Guasch5000/RosPiBot/LaTex/template/PFC.tex

%%%%%%%%%%%%%%%%%%%%%%%%%%%%%%%%%%%%%%%%%%%%%%%%%%%%%%%%%%%
%%														%%
%%				Plantilla LaTex PFC ETSEIB				%%
%%														%%
%%					Creado por:							%%
%%						Joan Guasch						%%
%%														%%
%%					Mail:								%%
%%						guasch5000@gmail.com				%%
%%														%%
%%%%%%%%%%%%%%%%%%%%%%%%%%%%%%%%%%%%%%%%%%%%%%%%%%%%%%%%%%%

\documentclass[twoside,12pt,a4paper, openright]{report}

\usepackage{lmodern}
\usepackage[T1]{fontenc}
\usepackage[spanish,activeacute,es-tabla]{babel}
\usepackage{mathtools}
\usepackage{graphicx}
\usepackage[inner=3.0cm,top=2.5cm,outer=2.0cm,bottom=2.5cm]{geometry}  
\usepackage{fancyhdr}
\usepackage{hyperref}
\usepackage{multicol}
\usepackage{float}
\usepackage{eurosym}
\usepackage{datatool}
\usepackage{chngcntr}
\usepackage{pgfgantt}
\usepackage{glossaries}
\usepackage{cite}

\counterwithin{figure}{chapter}
\counterwithin{table}{chapter}

\pagenumbering{gobble}
\usepackage{setspace}
\onehalfspacing

\setlength{\footskip}{42pt}

\title{ }
\author{ }
\date{ } % void to avoid put current date

\pagestyle{fancy}
\fancyhead[LO,RE]{\title{RosPiBot}}
\fancyhead[LE,RO]{\thepage}
\fancyfoot[LE,RO]{}
\fancyfoot[C]{}

\fancypagestyle{plain}{%
\fancyhead[LO,RE]{\title{RosPiBot}}
\fancyhead[LE,RO]{\thepage}
\fancyfoot[LE,RO]{}
\fancyfoot[C]{}
}

\begin{document}

\begin{center}
\vspace{5.0cm} 
 
%\end{center} 
\vspace{2.0cm} 
\LARGE{\\
Proyecto Final de Carrera\\
INGENIER\'IA INDUSTRIAL \\}
\vspace{2.0cm}  %Modificar para adaptar 
\Huge{
T'itulo del proyecto}
\vspace{3.0cm} \\ %Modificar para adaptar 
Memoria
\vspace{2.0cm} \\ %Modificar para adaptar 
\large{$\begin{array}{ll}
\mbox{Autor:} & \mbox{T'u nombre aqu'i} \\
\mbox{Director:} & \mbox{Nombre del director aqu'i} \\
\mbox{Convocatoria:} & \mbox{Mes 20XX}
\end{array}$}\\ 
\vspace{1.5cm} 
\Large{Escuela T'ecnica Superior de Ingenier'ia Industrial de Barcelona}\\ 
\vspace{0.5cm}

\end{center}

\thispagestyle{empty}

\newpage
\thispagestyle{empty}
\paragraph*{}

\newpage

\pagenumbering{arabic}
\fancyhead[LE,RO]{1} 

\addtocontents{toc}{~\hfill\textbf{P'agina}\par}

\begin{abstract}
\thispagestyle{fancy}

\addcontentsline{toc}{section}{Resumen}
En este proyecto... \\

\end{abstract}

\newpage
\fancyhead[LE,RO]{\thepage}
\tableofcontents

\newpage
\fancyhead[LE,RO]{\thepage}
\addcontentsline{toc}{section}{'Indice de figuras}
\listoffigures

\newpage
\fancyhead[LE,RO]{\thepage}
\addcontentsline{toc}{section}{'Indice de tablas}
\listoftables

\newpage
\fancyhead[LE,RO]{\thepage}

\newpage
\chapter*{Acr'onimos}
\addcontentsline{toc}{section}{Acr'onimos}
\begin{description}
\item[UPC] Universitat Politècnica de Catalunya
\end{description}

\newpage
\chapter{Introducci'on}
\section{Motivaci'on}

Este trabajo surge de...\\

\newpage
\section{Objetivos} \label{objetivos}
Los objetivos de...\\

\newpage
\section{Alcance}
El alcance de...\\

\chapter{Cuerpo}
\section{Tema central}

\chapter{Presupuesto}
\section{Planificaci'on}
Este proyecto se ha realizando en ...

\begin{figure}[H]
\begin{center}

\begin{ganttchart}[
vgrid={draw=none, dotted},
hgrid,
link/.style={-latex, red}
]{1}{15}
\gantttitle{Semanas}{15} \\
\gantttitlelist{1,...,15}{1} \\
\ganttbar{Planteamiento}{1}{3} \\

\ganttbar{Nudo}{3}{13}\\
\ganttbar{Desenlace}{14}{15}\\
\ganttlink{elem0}{elem1}
\ganttlink{elem1}{elem2}

\end{ganttchart}

\end{center}
\caption{Diagrama de Gantt}
\label{fig:diagramagantt}
\end{figure}

\chapter{Impacto Ambiental}
\section{Estudio}
El estudio medioambiental muestra que...

\chapter*{Conclusiones}
\addcontentsline{toc}{chapter}{Conclusiones}
A lo largo de este proyecto se han cumplido todos los objetivos propuestos...

\chapter*{Agradecimientos}
\addcontentsline{toc}{chapter}{Agradecimientos}
Un proyecto como este no se podría haber realizado sin...

\begin{thebibliography}{a}
\addcontentsline{toc}{chapter}{Bibliograf'aa}

\bibitem{ros} \textsc{Mart'inez, A. y Fern'andez, E.},
\textit{Learning ROS for Robotics Programming.}
PACKT Publishing, 2013  

\end{thebibliography}

\chapter*{Soporte infrom'atico}
\addcontentsline{toc}{chapter}{Soporte inform'atico}

\textbf{\LaTeX } Linux, Mac y Windows\\
Sistema de composición de textos, orientado especialmente a la creación de libros, documentos científicos y técnicos que contengan fórmulas matemáticas.\\

\end{document}
