Guasch5000/RosPiBot/Kicad/SecurePi_Board/nanain drill.PNG

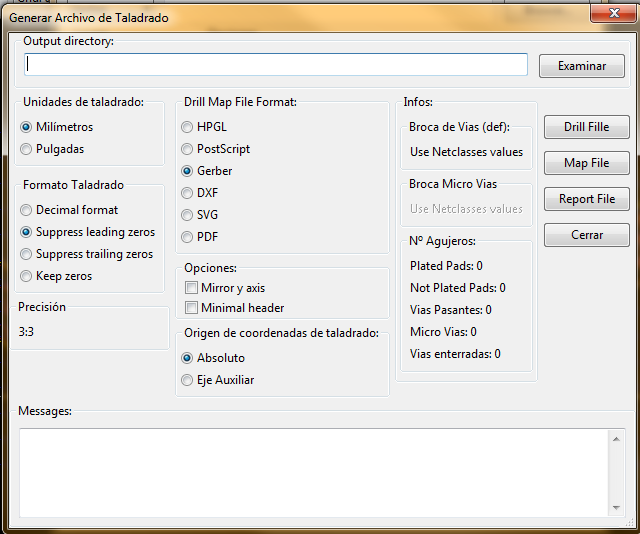
Kicad/SecurePi_Board/nanain drill.PNG
