Guasch5000/RosPiBot/Kicad/SecurePi_Board/nanain.PNG

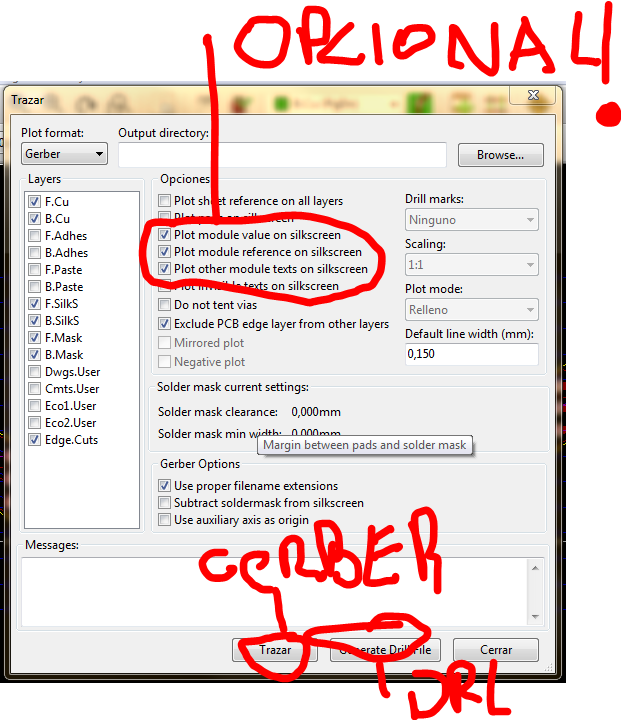
Kicad/SecurePi_Board/nanain.PNG
