Guasch5000/RosPiBot/Kicad/SecurePi_Board/securePscreen shoti.png

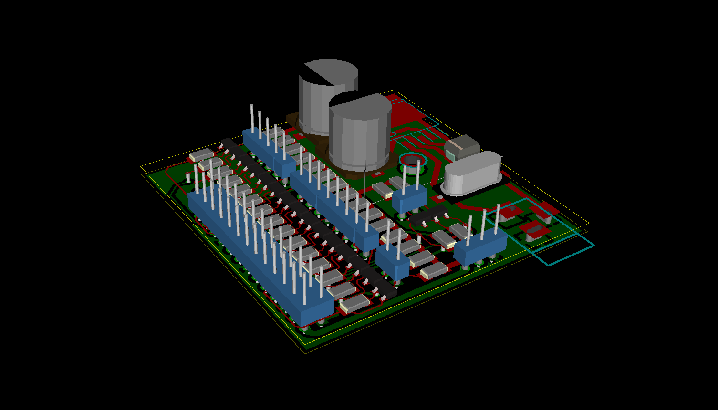
Kicad/SecurePi_Board/securePscreen shoti.png
