Guasch5000/RosPiBot/Kicad/SecurePi_Board/securePscreenshot2.png

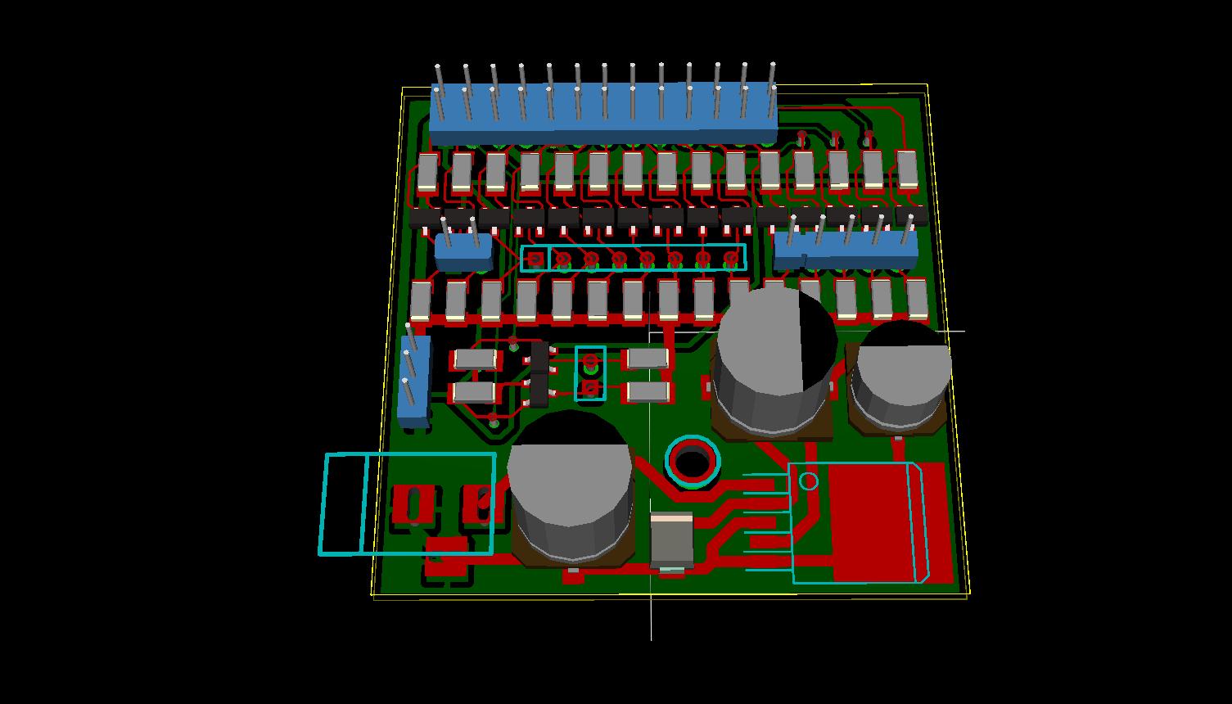
Kicad/SecurePi_Board/securePscreenshot2.png
