Guasch5000/RosPiBot/Kicad/SecurePi_Board/securePscreenshot3.png

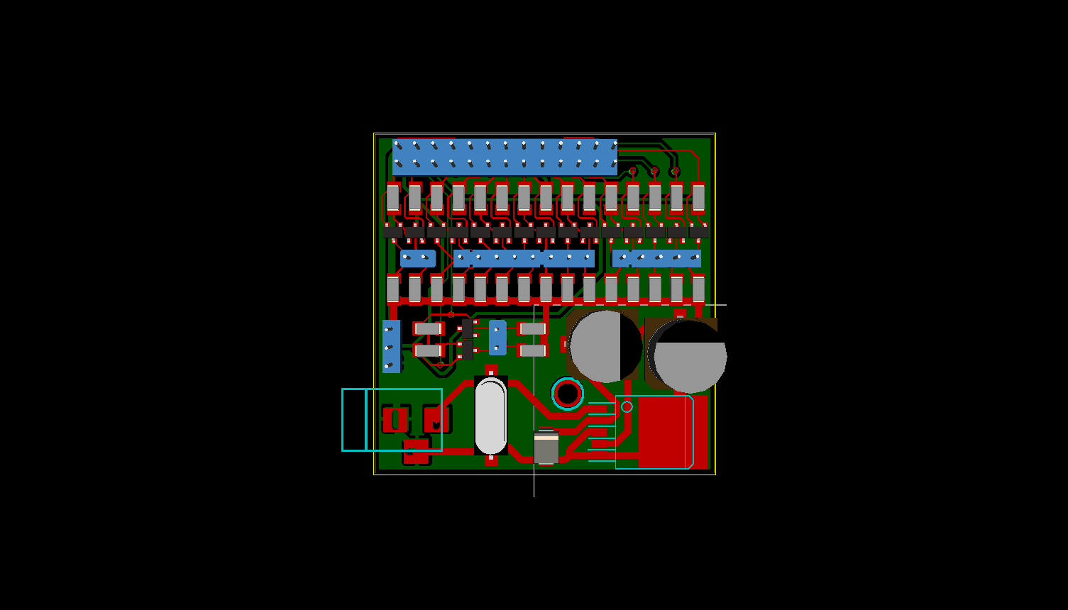
Kicad/SecurePi_Board/securePscreenshot3.png
