Guasch5000/RosPiBot/Kicad/SensorPi _Board/SensorPi_screenshoot1.png

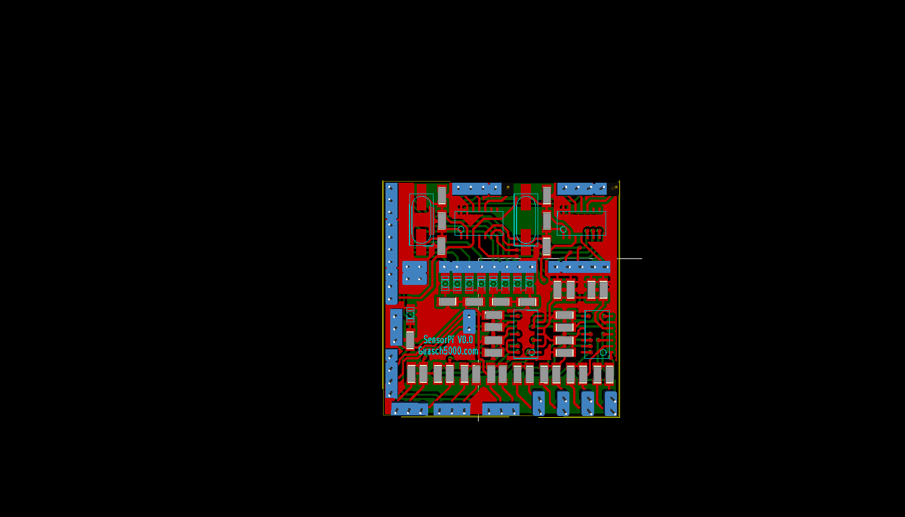
Kicad/SensorPi _Board/SensorPi_screenshoot1.png
