Guasch5000/RosPiBot/Kicad/SensorPi _Board/SensorPi_screenshoot2.png

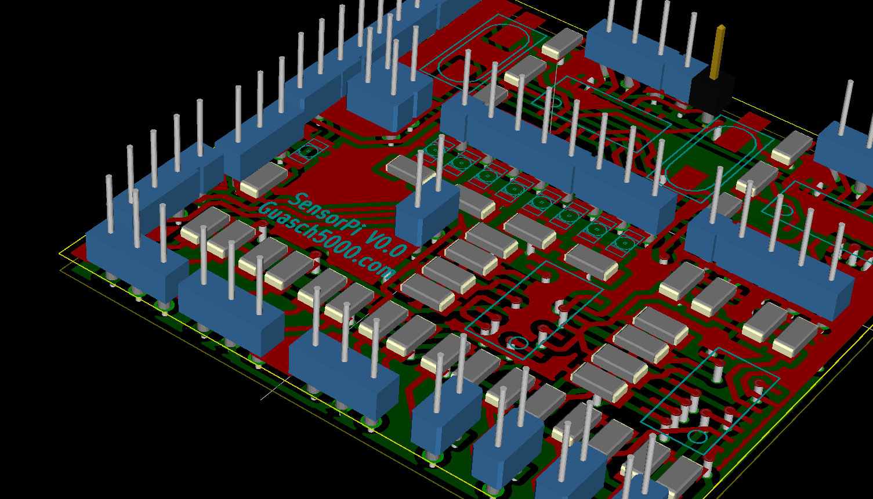
Kicad/SensorPi _Board/SensorPi_screenshoot2.png
