Guasch5000/RosPiBot/Kicad/SensorPi _Board/SensorPi_screenshoot3.png

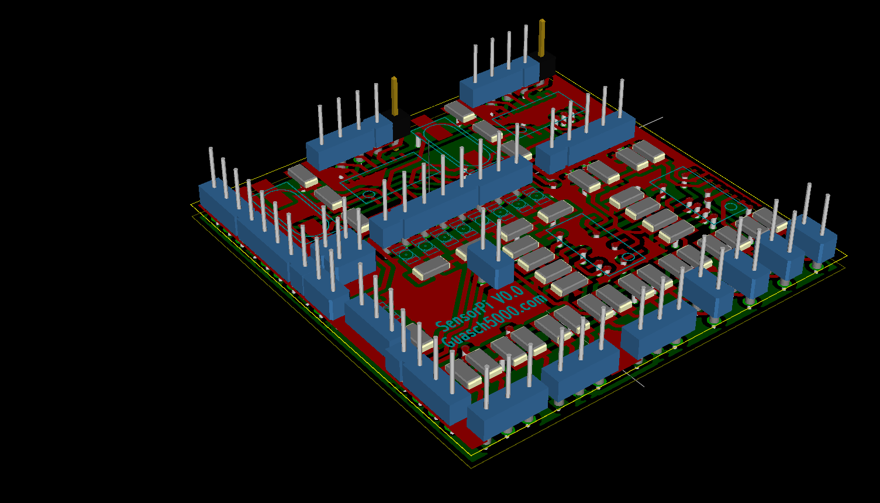
Kicad/SensorPi _Board/SensorPi_screenshoot3.png
