Guasch5000/RosPiBot/SolidWorks/Rueda Derecha.SLDASM

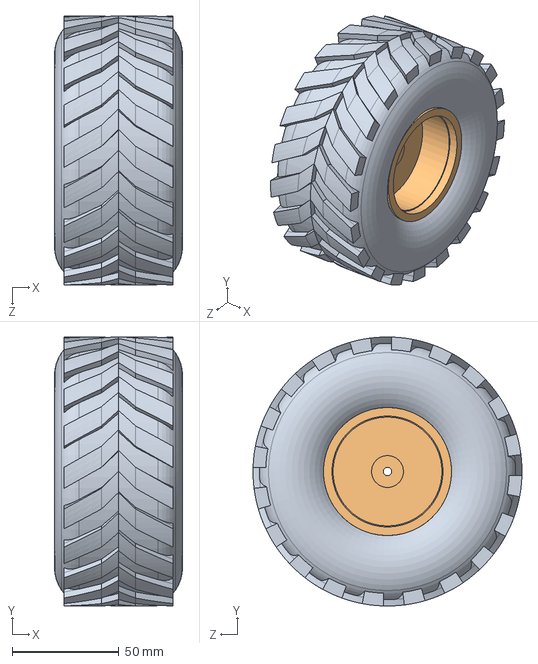
[picture p70: CAD file, 2014-05-18]
SolidWorks/Rueda Derecha.SLDASM
60.0 x 126.0 x 126.0 mm
Pneumatico
Llanta
