Guasch5000/RosPiBot/SolidWorks/Ensamblaje escuadra.SLDASM

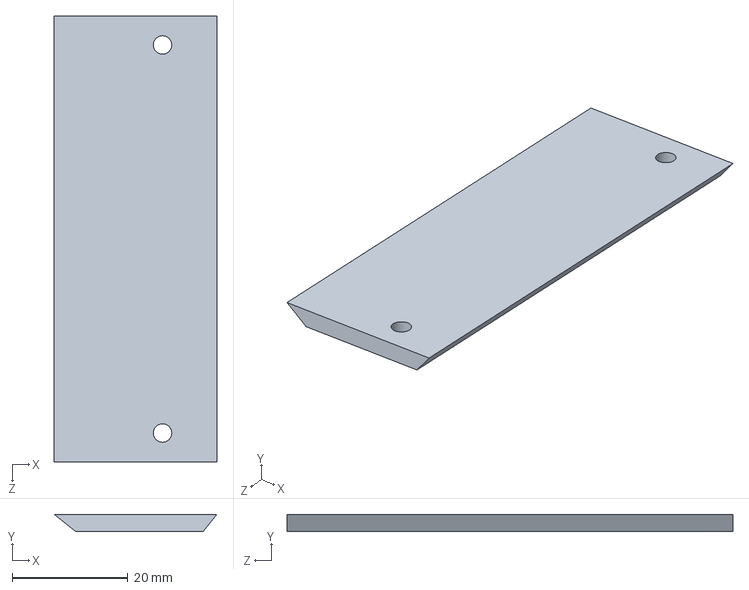
[picture p71: CAD file, 2014-05-18]
SolidWorks/Ensamblaje escuadra.SLDASM
28.1 x 3.00 x 77.0 mm
