Guasch5000/RosPiBot/SolidWorks/RosPiBot.SLDASM

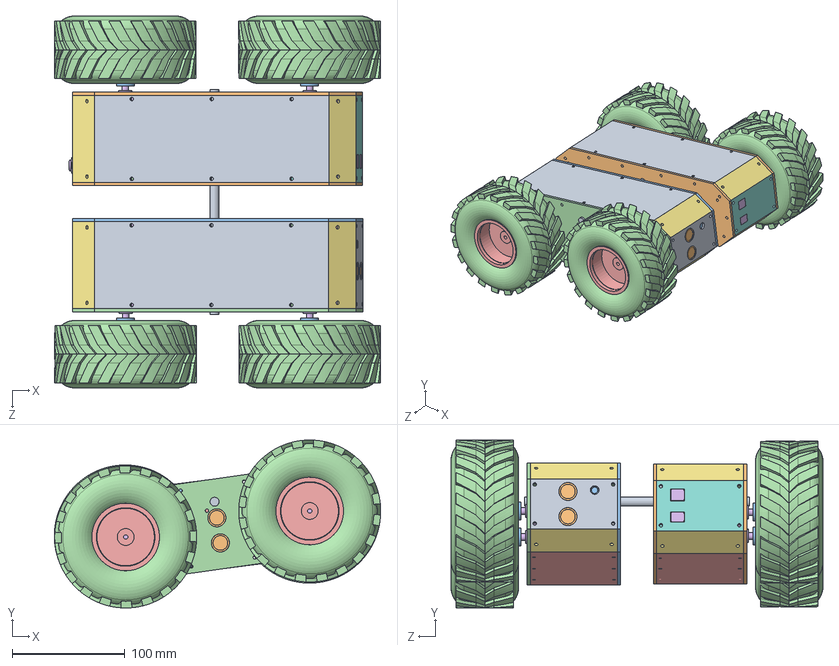
[picture p72: CAD file, 2014-05-18]
SolidWorks/RosPiBot.SLDASM
289.7 x 149.1 x 330.2 mm
Barra transversal
tapa lateral interior izquierda
tapa lateral interior derecha
Perfiles Estructura x 8
tapa inferior x 2
soporte interior ethernet
soporte interior switch
soporte interior raspberry
Switch
Ethernet panel mount
RaspberryPi
SecurePi
SensorPi
soporte router izquierdo
soporte drivers derecho
soporte bateria derecho
soporte bateria izquierdo
soporte driver izquierdo
MotorPi
Bateria 7.4V 6000mAh
soporte escuadras derechas x 8
soporte escuadras izquierdas x 8
tapa escuadra x 8
soporte delantero derecho
Panel delantero derecho
Sonar KS103 x 4
RaspiCam
soporte trasero derecho uno
soporte trasero derecho dos
Sharp 2Y0A02 x 2
USB panel mount x 2
panel trasero derecho
tapa superior x 2
soporte router derecho
Router
tapa lateral exterior derecha
prisma x 2
Motor Hsiang Neng x 4
soporte delantero izquierdo
Panel delantero izquierdo
soporte simple x 2
panel trasero izquierdo
soporte trasero izquierdo
Led 10 Bar
Jack Power
Int antivandalico
Porta fusible
GY-80
soporte imu
tapa lateral exterior izquierda
Coupling x 4
Pneumatico x 4
Llanta x 4
