Guasch5000/RosPiBot/SolidWorks/SensorPi.SLDPRT

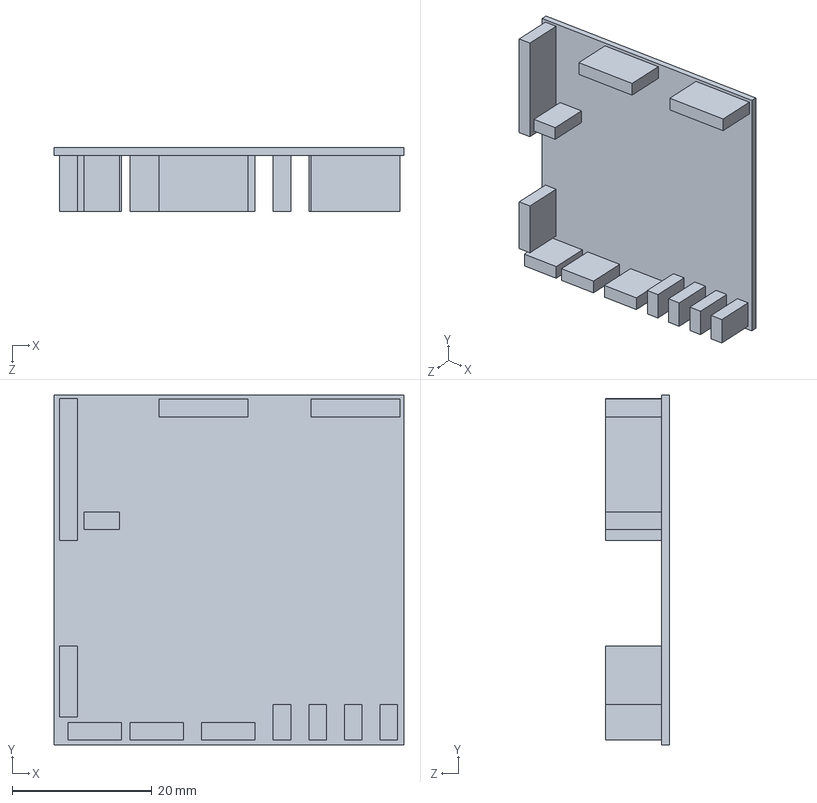
[picture p73: CAD file, 2014-05-18]
SolidWorks/SensorPi.SLDPRT
50.0 x 50.0 x 9.20 mm
