Guasch5000/RosPiBot/SolidWorks/tapa superior.SLDPRT

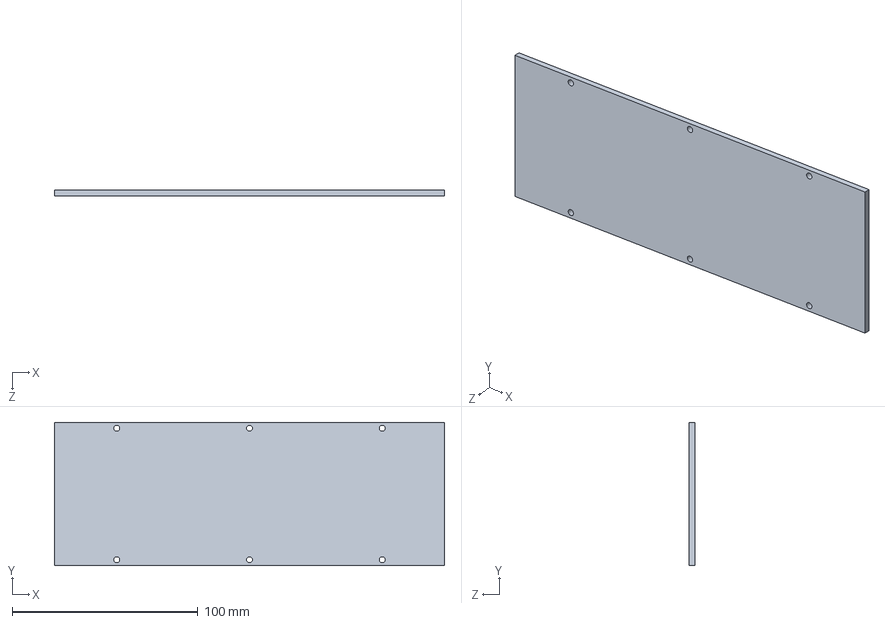
[picture p74: CAD file, 2014-05-18]
SolidWorks/tapa superior.SLDPRT
210.0 x 77.0 x 3.00 mm
