Guasch5000/RosPiBot/SolidWorks/soporte delantero izquierdo.SLDPRT

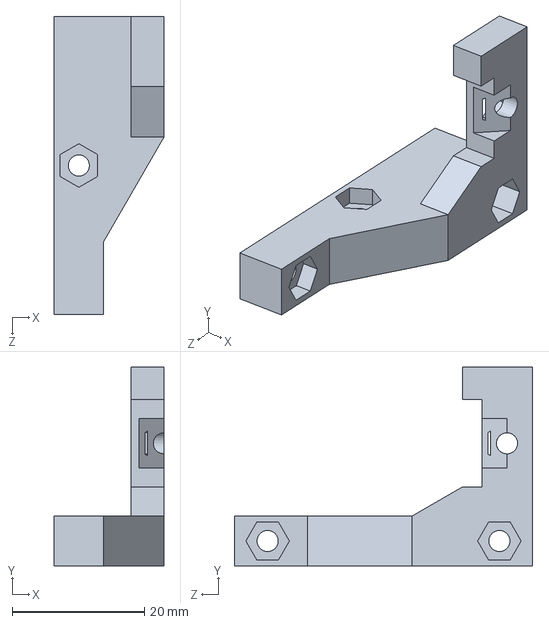
[picture p75: CAD file, 2014-05-18]
SolidWorks/soporte delantero izquierdo.SLDPRT
16.6 x 30.0 x 45.0 mm
