Guasch5000/RosPiBot/SolidWorks/tapa lateral exterior derecha.SLDPRT

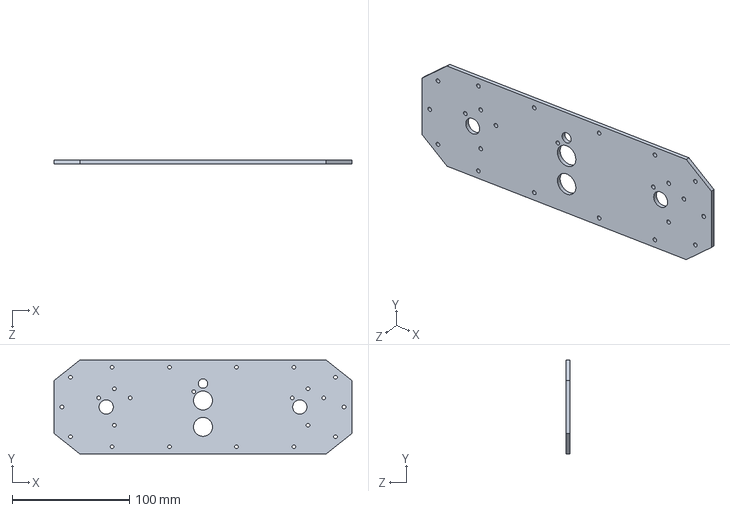
[picture p76: CAD file, 2014-05-18]
SolidWorks/tapa lateral exterior derecha.SLDPRT
254.0 x 80.0 x 3.00 mm
