Guasch5000/RosPiBot/SolidWorks/soporte imu.SLDPRT

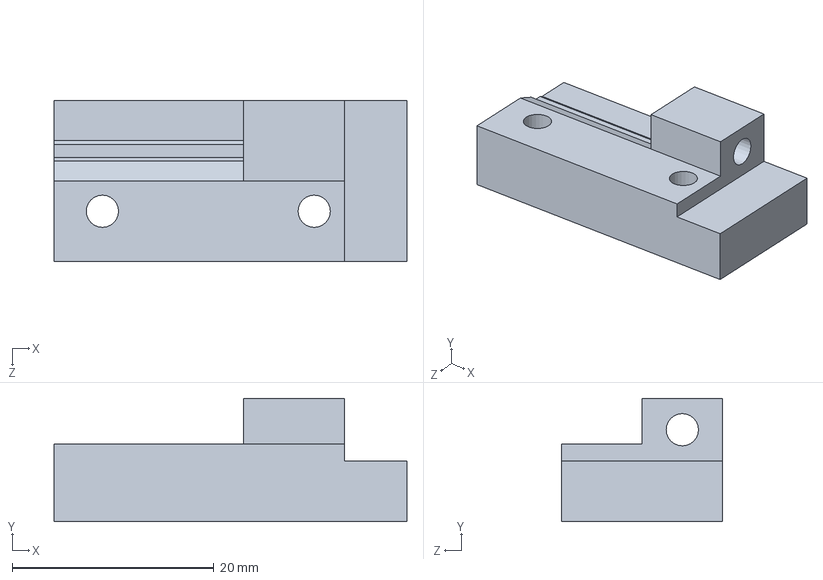
[picture p77: CAD file, 2014-05-18]
SolidWorks/soporte imu.SLDPRT
35.0 x 12.2 x 16.0 mm
