Guasch5000/RosPiBot/SolidWorks/Llanta.SLDPRT

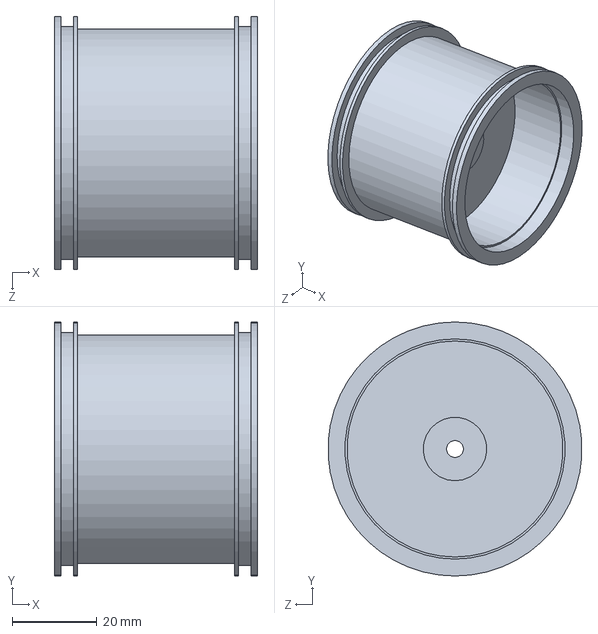
[picture p78: CAD file, 2014-05-18]
SolidWorks/Llanta.SLDPRT
48.0 x 60.0 x 59.9 mm
