Guasch5000/RosPiBot/SolidWorks/soporte trasero derecho dos.SLDPRT

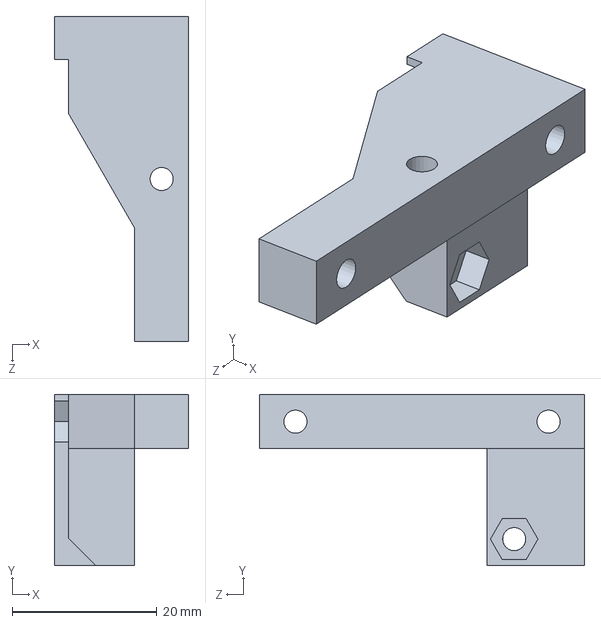
[picture p79: CAD file, 2014-05-18]
SolidWorks/soporte trasero derecho dos.SLDPRT
18.6 x 23.6 x 45.0 mm
