Guasch5000/RosPiBot/SolidWorks/Panel delantero izquierdo.SLDPRT

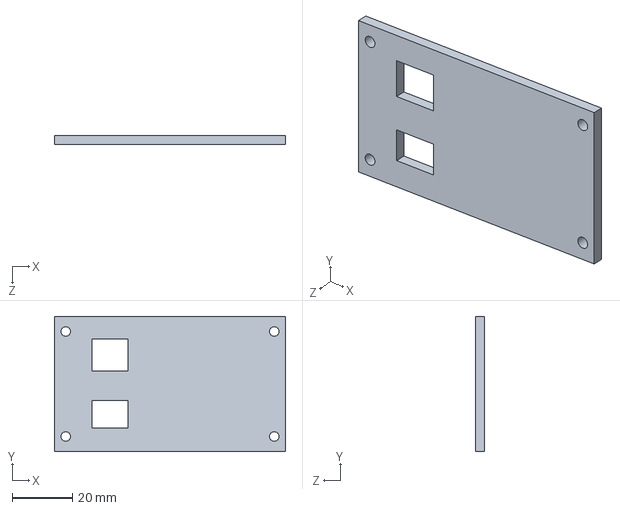
[picture p80: CAD file, 2014-05-18]
SolidWorks/Panel delantero izquierdo.SLDPRT
77.0 x 45.0 x 3.00 mm
