Guasch5000/RosPiBot/SolidWorks/Jack Power.SLDPRT

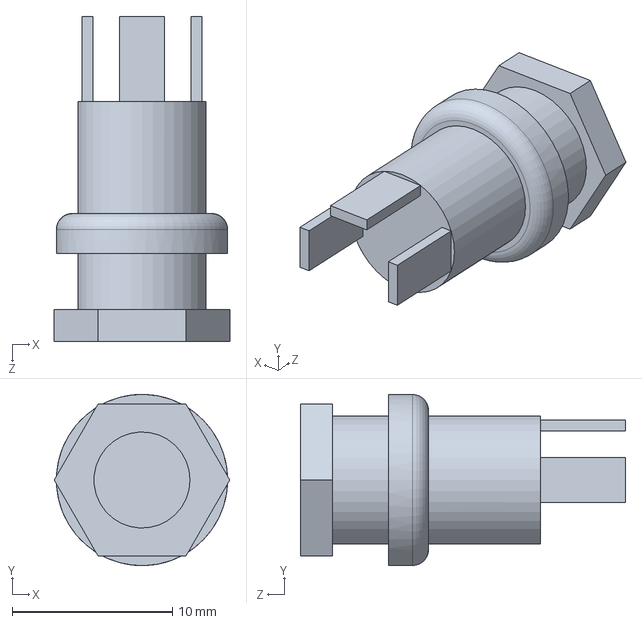
[picture p81: CAD file, 2014-05-18]
SolidWorks/Jack Power.SLDPRT
11.0 x 10.7 x 20.3 mm
