Guasch5000/RosPiBot/SolidWorks/soporte simple.SLDPRT

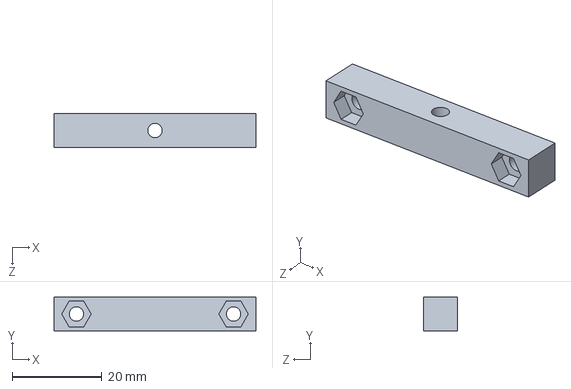
[picture p82: CAD file, 2014-05-18]
SolidWorks/soporte simple.SLDPRT
45.0 x 7.50 x 7.50 mm
