Guasch5000/RosPiBot/SolidWorks/soporte delantero derecho.SLDPRT

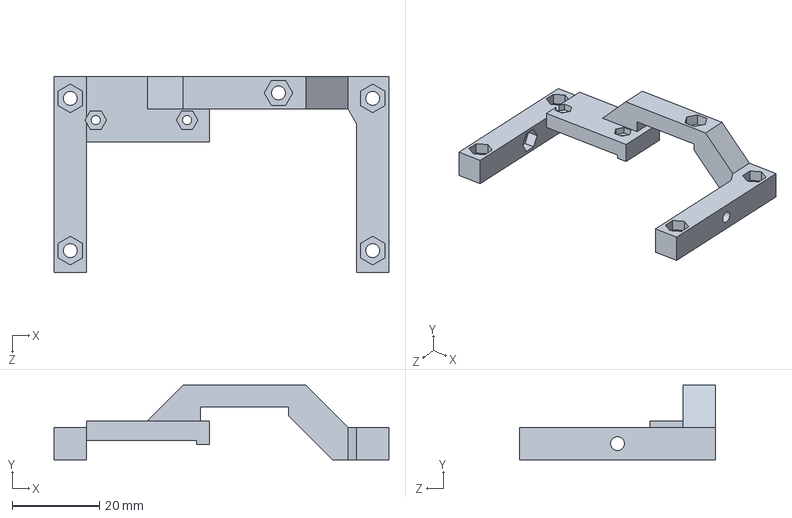
[picture p83: CAD file, 2014-05-18]
SolidWorks/soporte delantero derecho.SLDPRT
77.0 x 17.2 x 45.0 mm
