Guasch5000/RosPiBot/SolidWorks/panel trasero derecho.SLDPRT

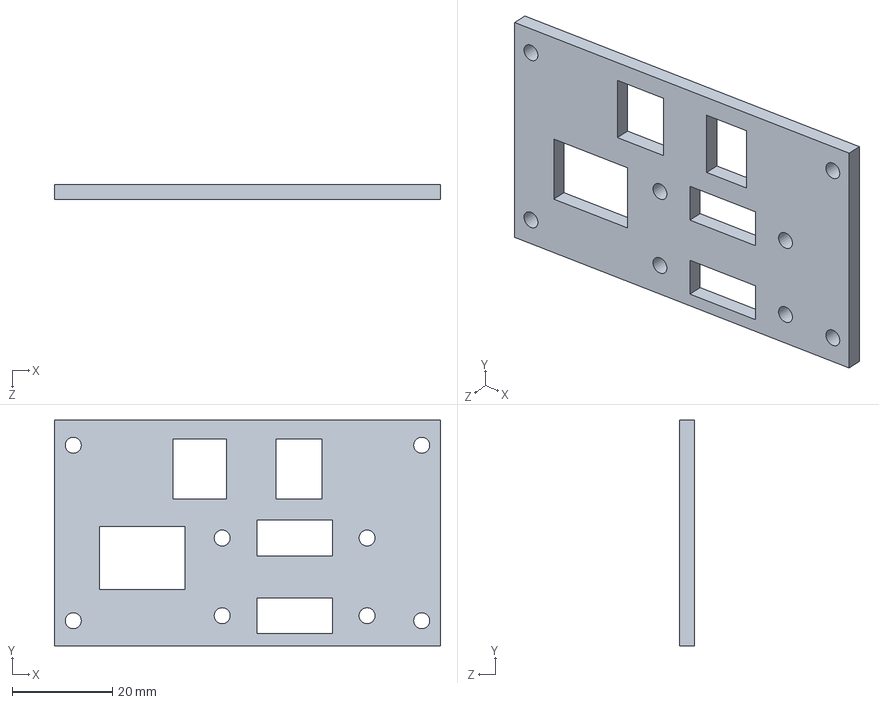
[picture p84: CAD file, 2014-05-18]
SolidWorks/panel trasero derecho.SLDPRT
77.0 x 45.0 x 3.00 mm
