Guasch5000/RosPiBot/SolidWorks/soporte interior raspberry.SLDPRT

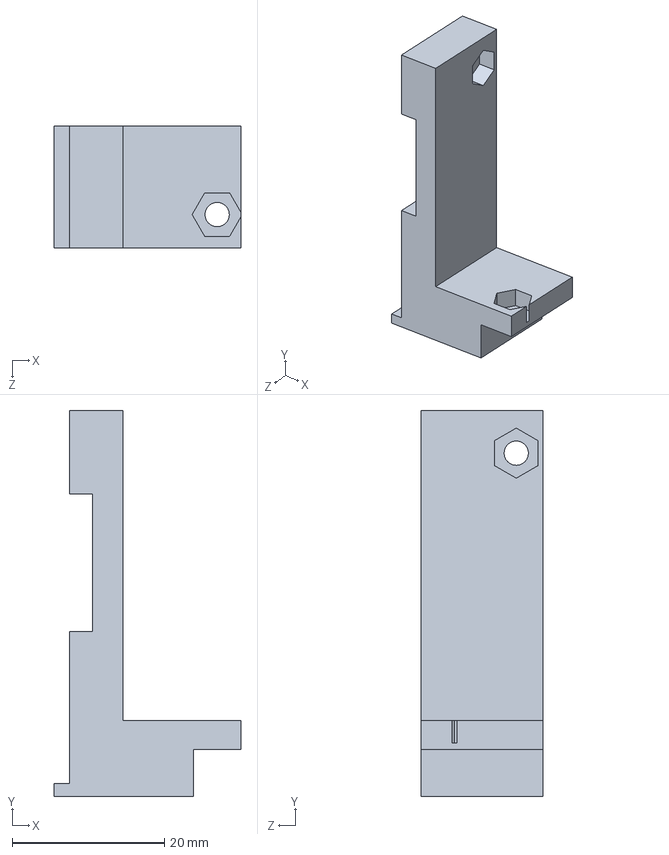
[picture p85: CAD file, 2014-05-18]
SolidWorks/soporte interior raspberry.SLDPRT
24.5 x 50.7 x 16.0 mm
