Guasch5000/RosPiBot/SolidWorks/soporte bateria izquierdo.SLDPRT

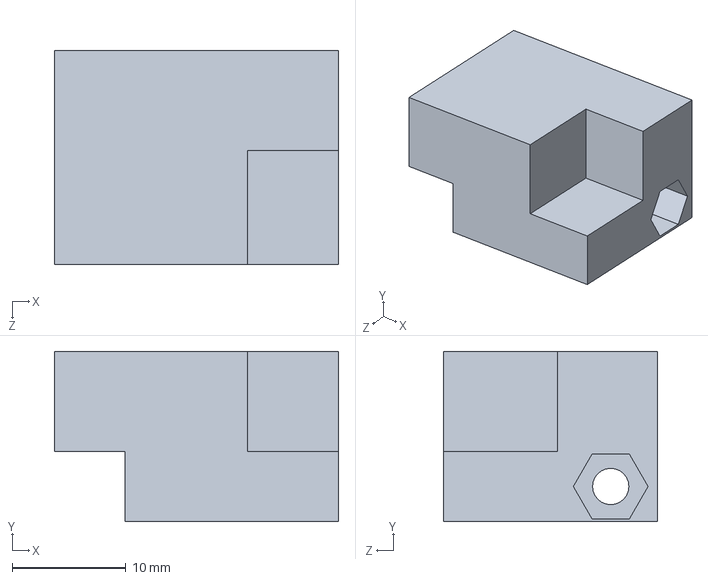
[picture p86: CAD file, 2014-05-18]
SolidWorks/soporte bateria izquierdo.SLDPRT
25.0 x 15.0 x 18.8 mm
