Guasch5000/RosPiBot/SolidWorks/Lateral derecho externo placa test.SLDPRT

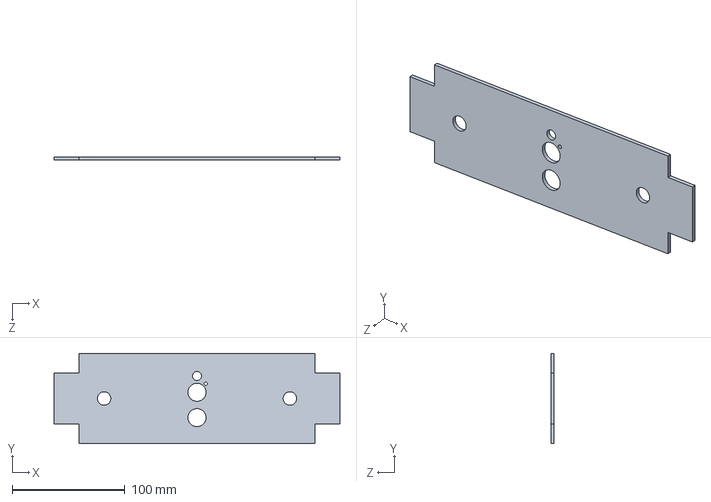
[picture p87: CAD file, 2014-05-18]
SolidWorks/Lateral derecho externo placa test.SLDPRT
254.0 x 80.0 x 3.00 mm
