Guasch5000/RosPiBot/SolidWorks/tapa escuadra.SLDPRT

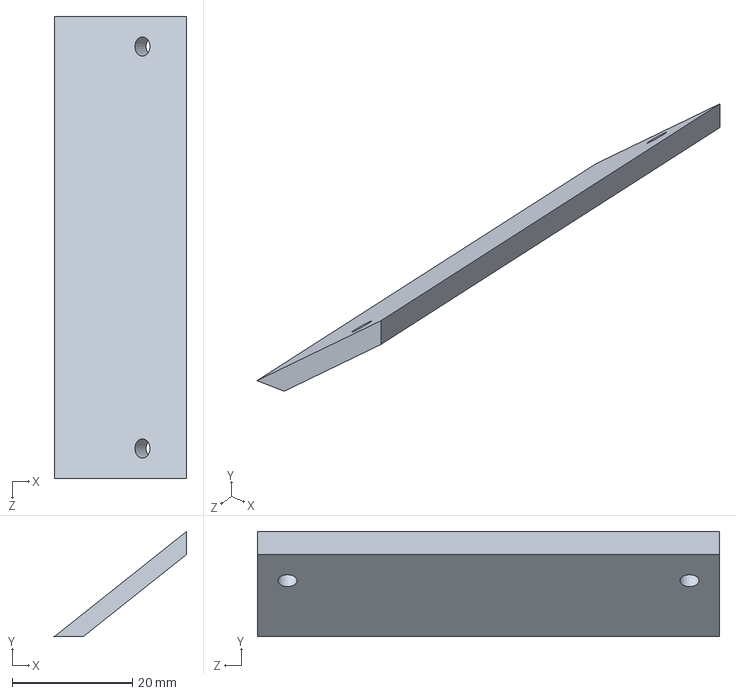
[picture p88: CAD file, 2014-05-18]
SolidWorks/tapa escuadra.SLDPRT
22.0 x 17.5 x 77.0 mm
