Guasch5000/RosPiBot/SolidWorks/Placa test.SLDPRT

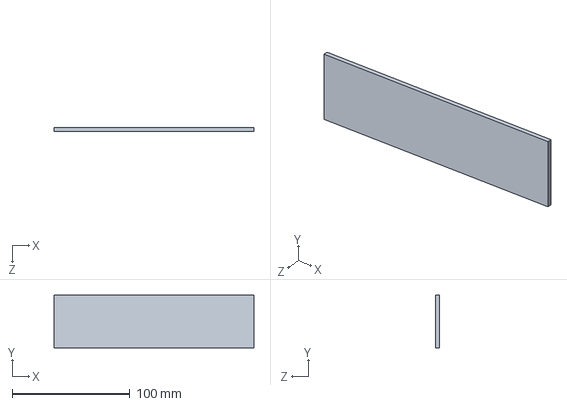
[picture p89: CAD file, 2014-05-18]
SolidWorks/Placa test.SLDPRT
170.0 x 45.0 x 3.00 mm
