Guasch5000/RosPiBot/SolidWorks/soporte router derecho.SLDPRT

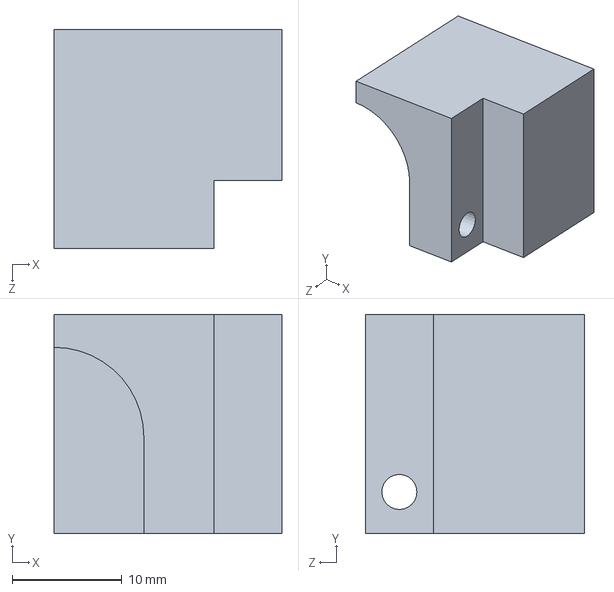
[picture p90: CAD file, 2014-05-18]
SolidWorks/soporte router derecho.SLDPRT
20.8 x 20.0 x 20.0 mm
