Guasch5000/RosPiBot/SolidWorks/USB panel mount.SLDPRT

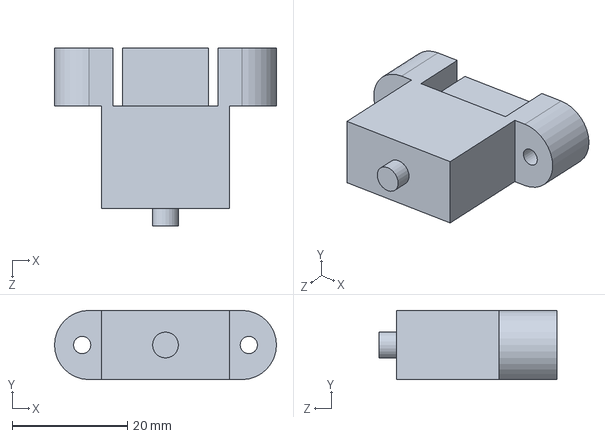
[picture p91: CAD file, 2014-05-18]
SolidWorks/USB panel mount.SLDPRT
38.5 x 12.0 x 30.8 mm
