Guasch5000/RosPiBot/SolidWorks/GY-80.SLDPRT

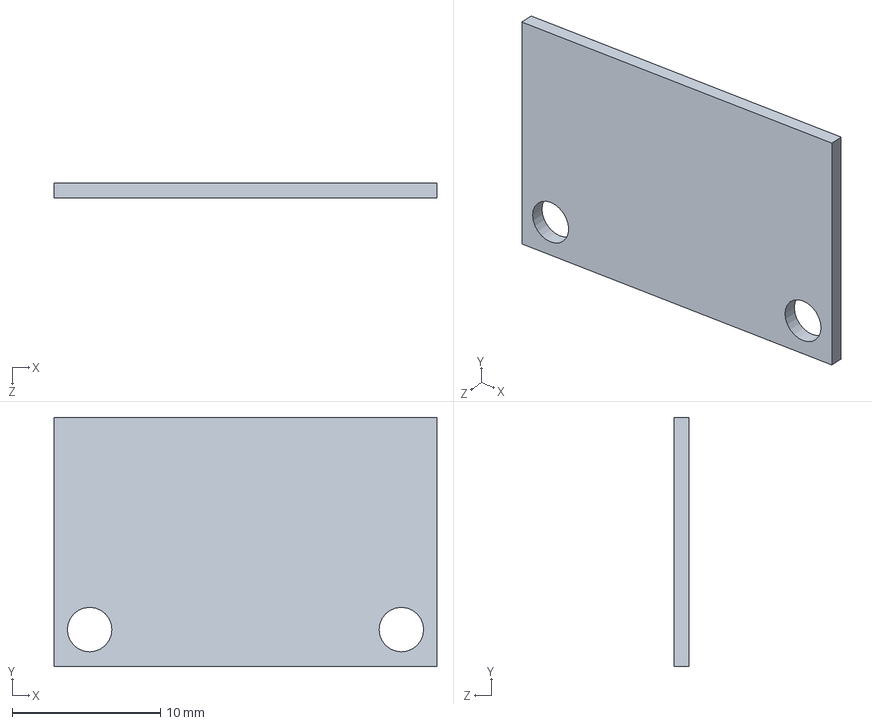
[picture p92: CAD file, 2014-05-18]
SolidWorks/GY-80.SLDPRT
25.8 x 16.8 x 1.00 mm
