Guasch5000/RosPiBot/SolidWorks/soporte driver izquierdo.SLDPRT

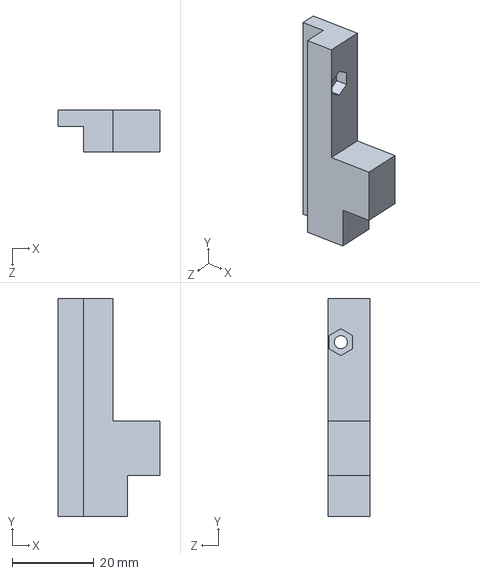
[picture p93: CAD file, 2014-05-18]
SolidWorks/soporte driver izquierdo.SLDPRT
25.0 x 53.4 x 10.2 mm
