Guasch5000/RosPiBot/SolidWorks/Led 10 Bar.SLDPRT

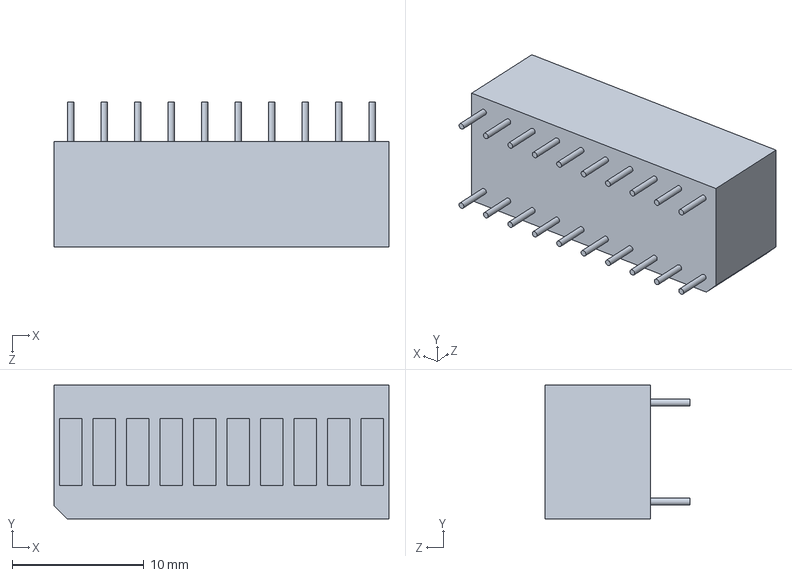
[picture p94: CAD file, 2014-05-18]
SolidWorks/Led 10 Bar.SLDPRT
25.4 x 10.2 x 11.0 mm
