Guasch5000/RosPiBot/SolidWorks/Ethernet panel mount.SLDPRT

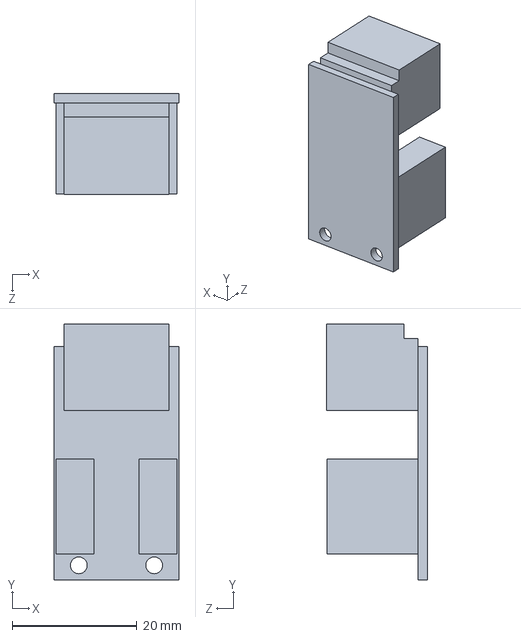
[picture p95: CAD file, 2014-05-18]
SolidWorks/Ethernet panel mount.SLDPRT
20.0 x 41.1 x 16.2 mm
