Guasch5000/RosPiBot/SolidWorks/Barra transversal.SLDPRT

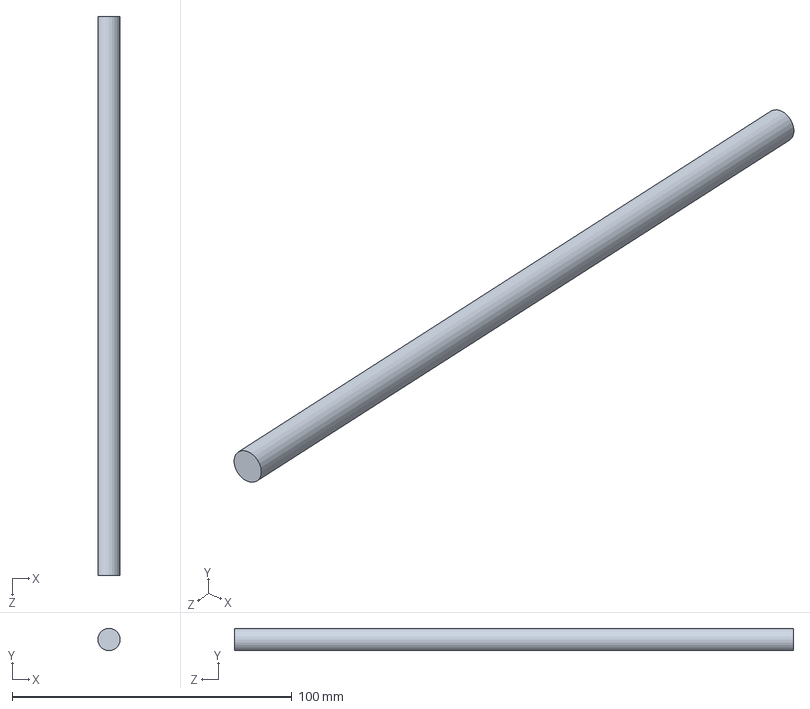
[picture p96: CAD file, 2014-05-18]
SolidWorks/Barra transversal.SLDPRT
8.00 x 8.00 x 200.0 mm
