Guasch5000/RosPiBot/SolidWorks/RaspberryPi.SLDPRT

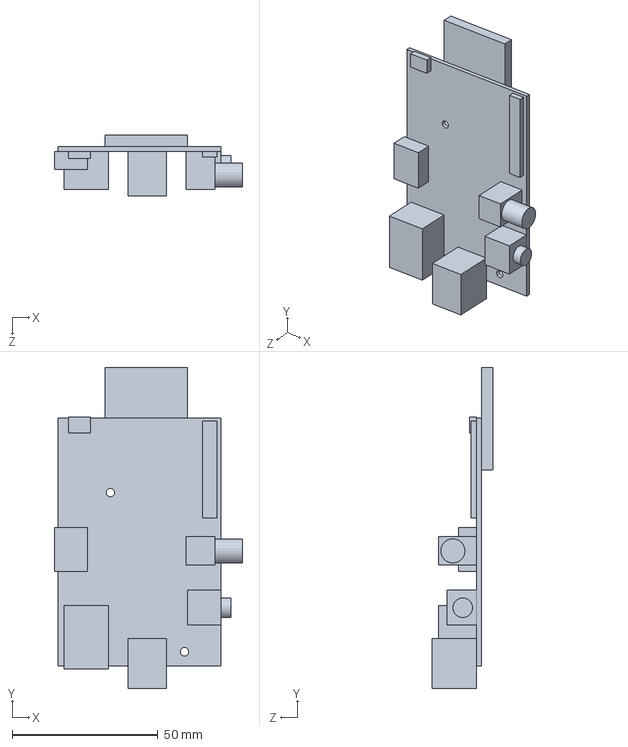
[picture p97: CAD file, 2014-05-18]
SolidWorks/RaspberryPi.SLDPRT
64.5 x 110.1 x 20.9 mm
