Guasch5000/RosPiBot/SolidWorks/soporte interior ethernet.SLDPRT

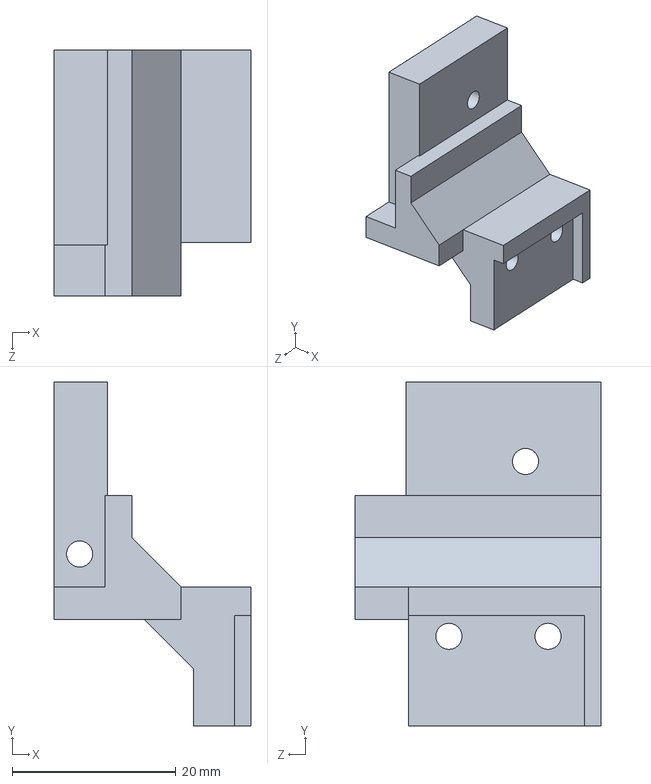
[picture p98: CAD file, 2014-05-18]
SolidWorks/soporte interior ethernet.SLDPRT
24.0 x 42.0 x 30.0 mm
