Guasch5000/RosPiBot/SolidWorks/Router.SLDPRT

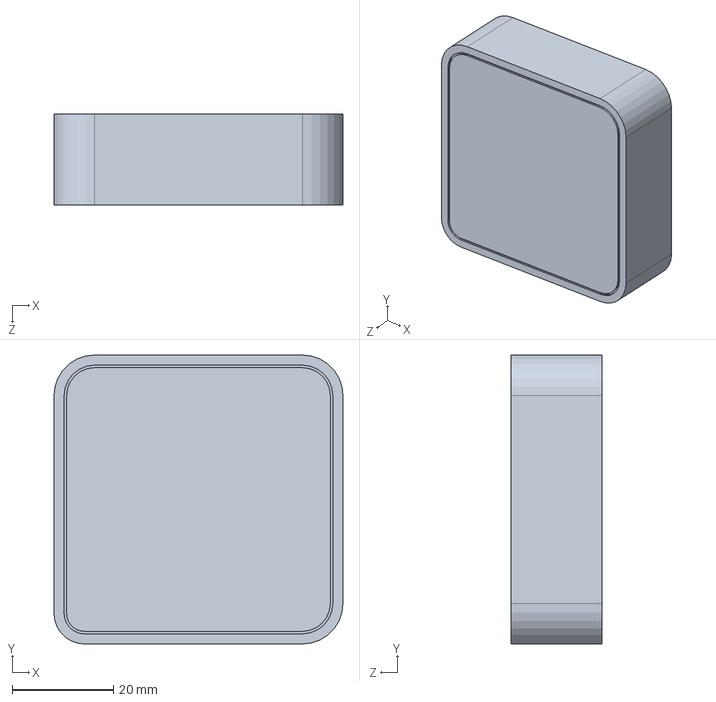
[picture p99: CAD file, 2014-05-18]
SolidWorks/Router.SLDPRT
57.0 x 57.0 x 18.0 mm
