Guasch5000/RosPiBot/SolidWorks/soporte escuadras derechas.SLDPRT

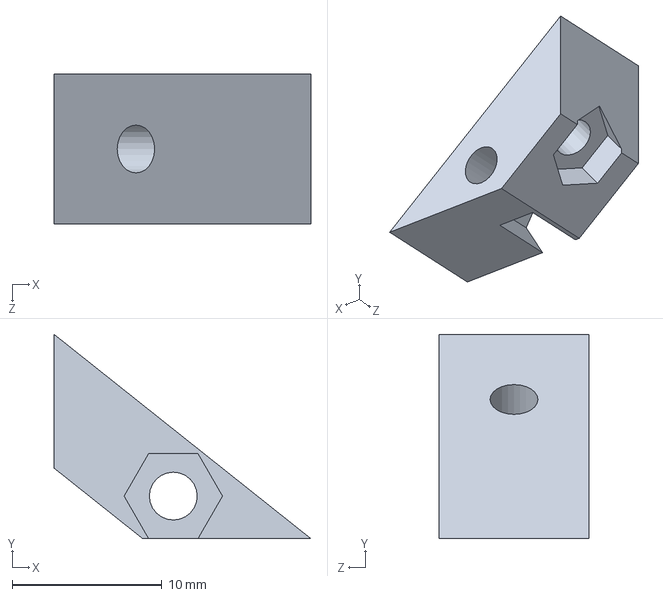
[picture p100: CAD file, 2014-05-18]
SolidWorks/soporte escuadras derechas.SLDPRT
17.2 x 13.7 x 10.0 mm
