Guasch5000/RosPiBot/SolidWorks/panel trasero izquierdo.SLDPRT

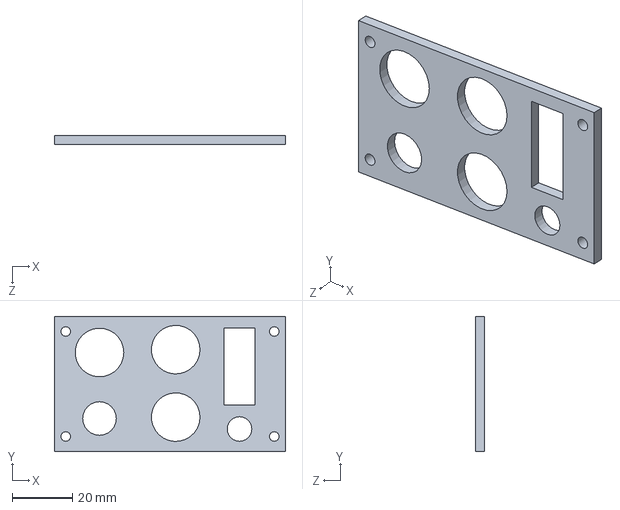
[picture p101: CAD file, 2014-05-18]
SolidWorks/panel trasero izquierdo.SLDPRT
77.0 x 45.0 x 3.00 mm
