Guasch5000/RosPiBot/SolidWorks/MotorPi.SLDPRT

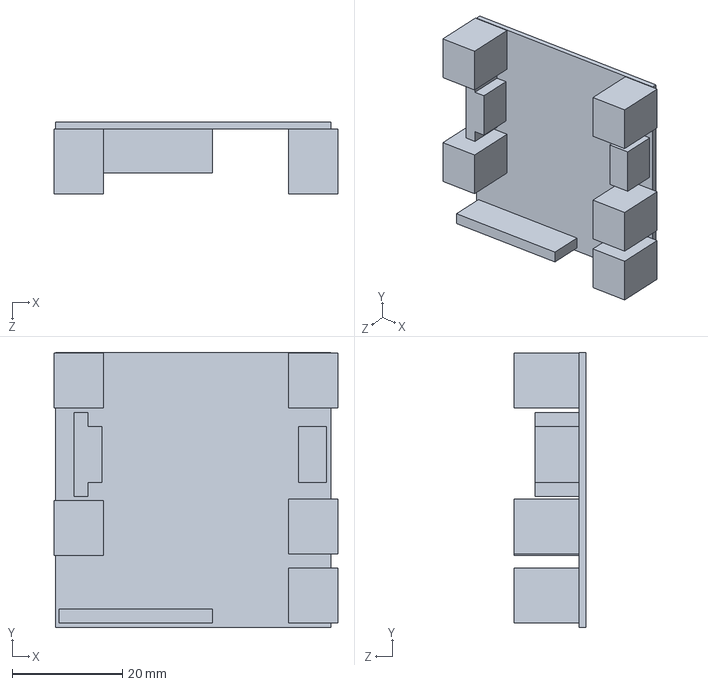
[picture p102: CAD file, 2014-05-18]
SolidWorks/MotorPi.SLDPRT
51.6 x 50.0 x 13.0 mm
