Guasch5000/RosPiBot/SolidWorks/Bateria 7.4V 6000mAh.SLDPRT

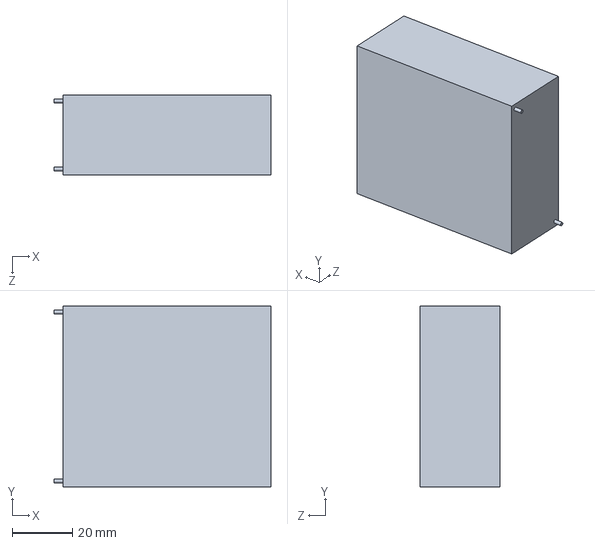
[picture p103: CAD file, 2014-05-18]
SolidWorks/Bateria 7.4V 6000mAh.SLDPRT
72.0 x 60.0 x 26.7 mm
