Guasch5000/RosPiBot/SolidWorks/soporte trasero izquierdo.SLDPRT

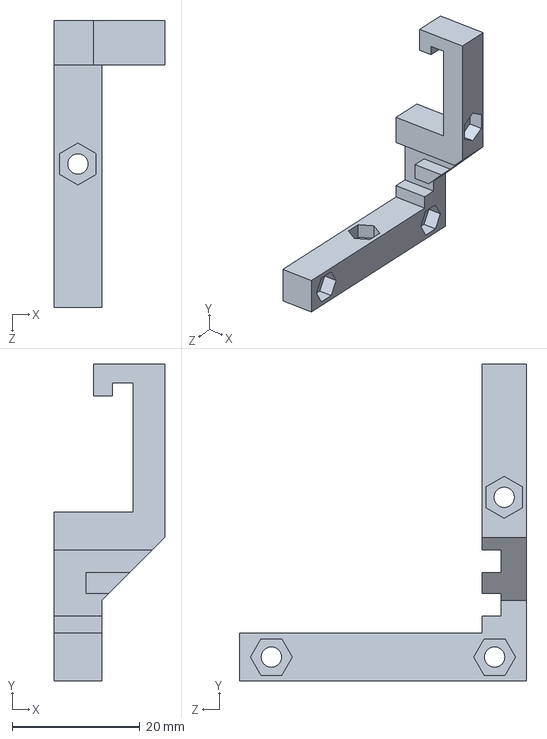
[picture p104: CAD file, 2014-05-18]
SolidWorks/soporte trasero izquierdo.SLDPRT
17.4 x 49.7 x 45.0 mm
