Guasch5000/RosPiBot/SolidWorks/soporte bateria derecho.SLDPRT

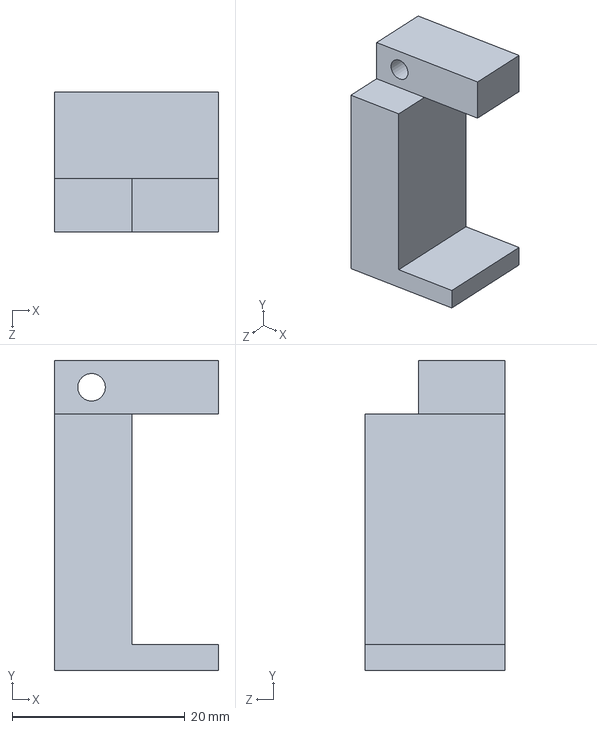
[picture p105: CAD file, 2014-05-18]
SolidWorks/soporte bateria derecho.SLDPRT
19.0 x 35.9 x 16.2 mm
