Guasch5000/RosPiBot/SolidWorks/soporte router izquierdo.SLDPRT

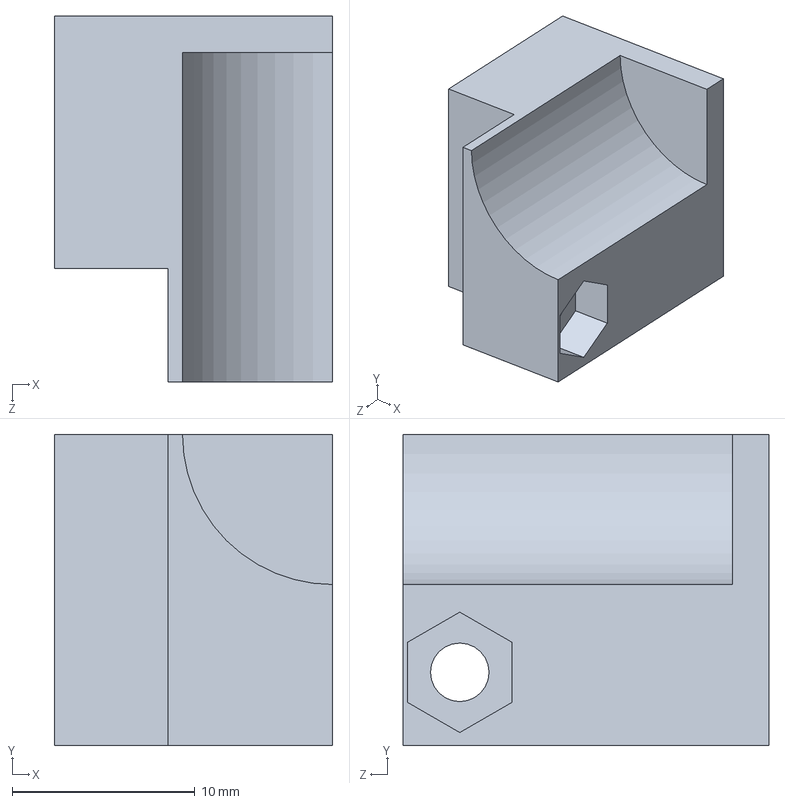
[picture p106: CAD file, 2014-05-18]
SolidWorks/soporte router izquierdo.SLDPRT
15.2 x 17.0 x 20.0 mm
