Guasch5000/RosPiBot/SolidWorks/prisma.SLDPRT

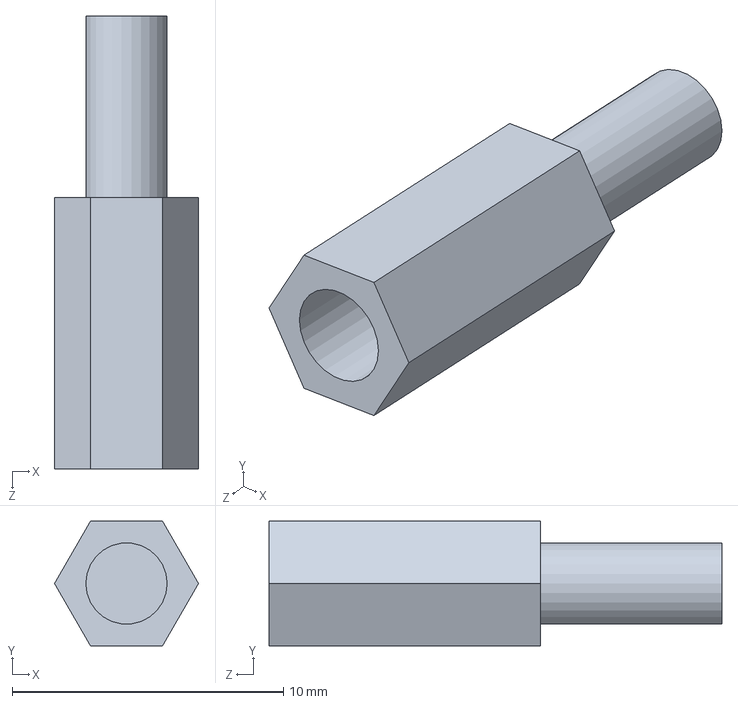
[picture p107: CAD file, 2014-05-18]
SolidWorks/prisma.SLDPRT
5.31 x 4.60 x 16.7 mm
