Guasch5000/RosPiBot/SolidWorks/Porta fusible.SLDPRT

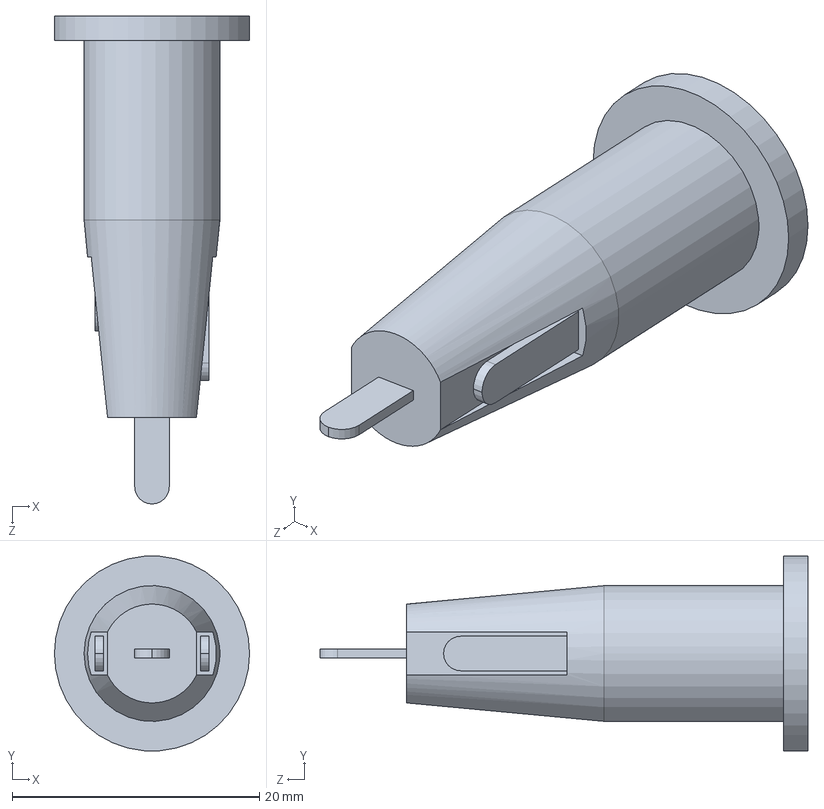
[picture p108: CAD file, 2014-05-18]
SolidWorks/Porta fusible.SLDPRT
15.8 x 15.7 x 39.5 mm
