Guasch5000/RosPiBot/SolidWorks/SecurePi.SLDPRT

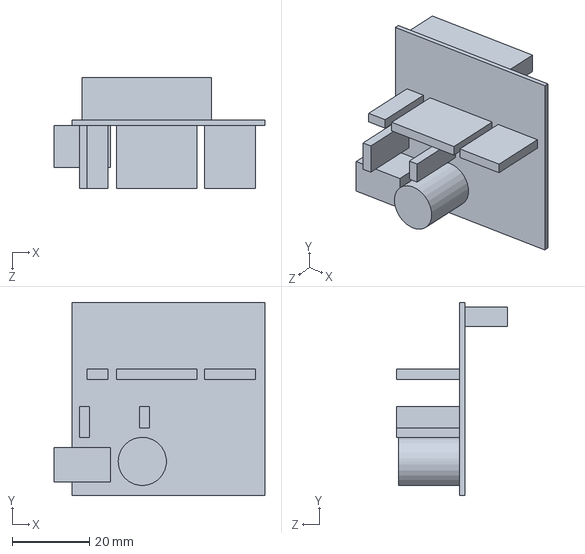
[picture p109: CAD file, 2014-05-18]
SolidWorks/SecurePi.SLDPRT
54.6 x 50.0 x 28.8 mm
