Guasch5000/RosPiBot/SolidWorks/Pneumatico.SLDPRT

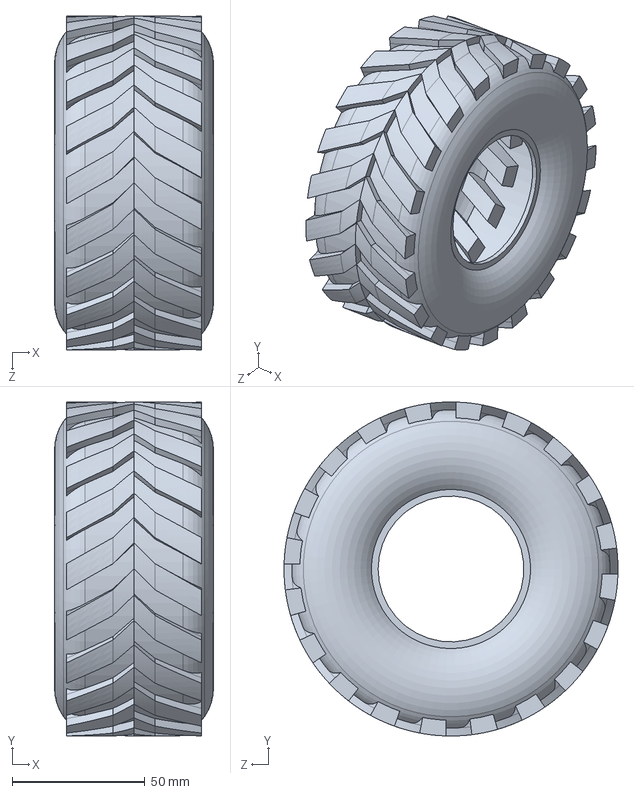
[picture p110: CAD file, 2014-05-18]
SolidWorks/Pneumatico.SLDPRT
60.0 x 126.0 x 126.0 mm
