Guasch5000/RosPiBot/SolidWorks/Sharp 2Y0A02.SLDPRT

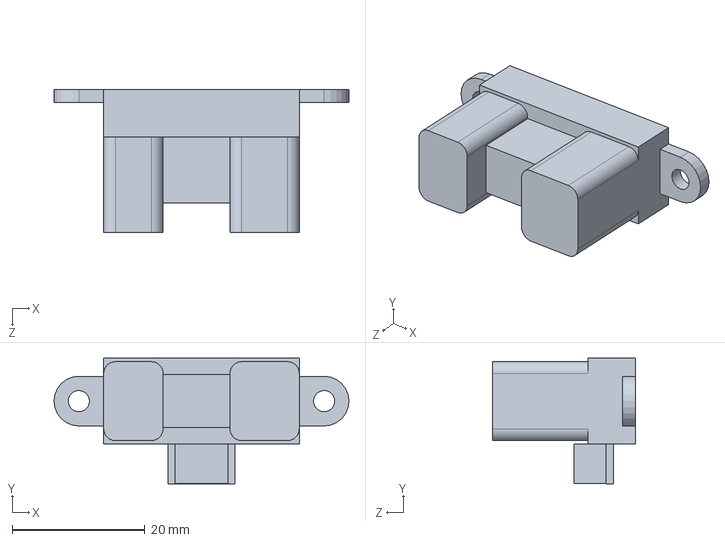
[picture p111: CAD file, 2014-05-18]
SolidWorks/Sharp 2Y0A02.SLDPRT
44.5 x 19.0 x 21.6 mm
