Guasch5000/RosPiBot/SolidWorks/Perfiles Estructura.SLDPRT

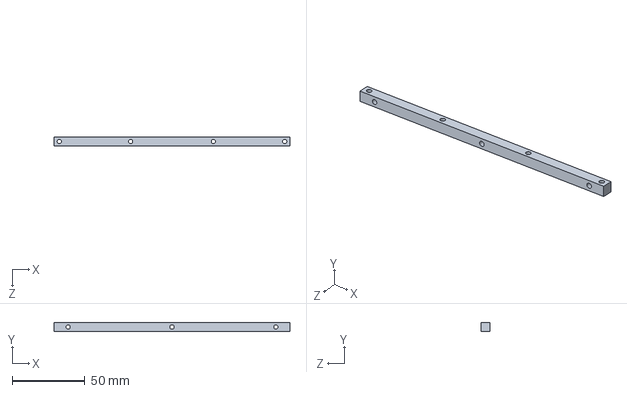
[picture p112: CAD file, 2014-05-18]
SolidWorks/Perfiles Estructura.SLDPRT
162.4 x 6.20 x 6.20 mm
