Guasch5000/RosPiBot/SolidWorks/soporte interior switch.SLDPRT

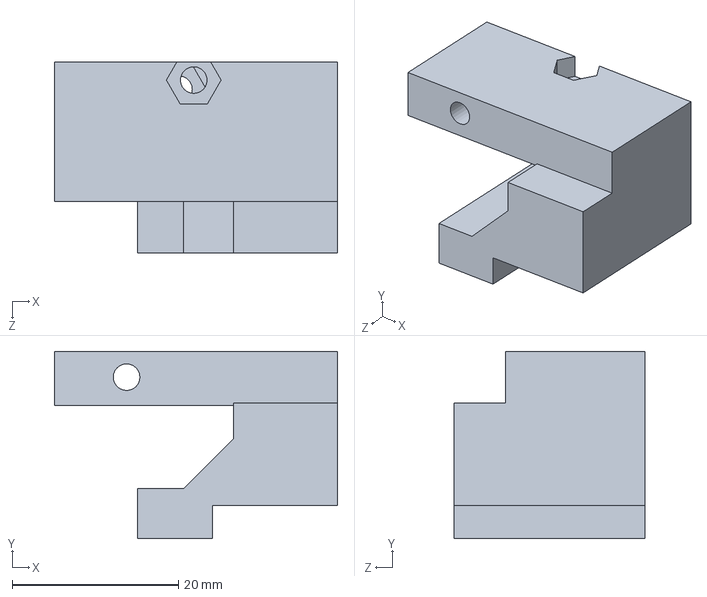
[picture p113: CAD file, 2014-05-18]
SolidWorks/soporte interior switch.SLDPRT
34.0 x 22.5 x 23.0 mm
