Guasch5000/RosPiBot/SolidWorks/Int antivandalico.SLDPRT

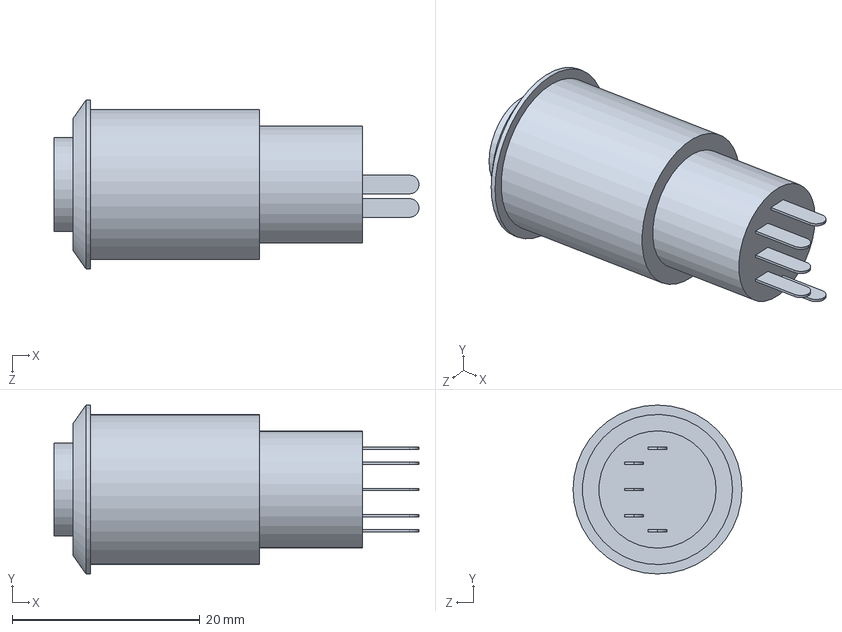
[picture p114: CAD file, 2014-05-18]
SolidWorks/Int antivandalico.SLDPRT
38.9 x 18.0 x 18.0 mm
