Guasch5000/RosPiBot/SolidWorks/Motor Hsiang Neng.SLDPRT

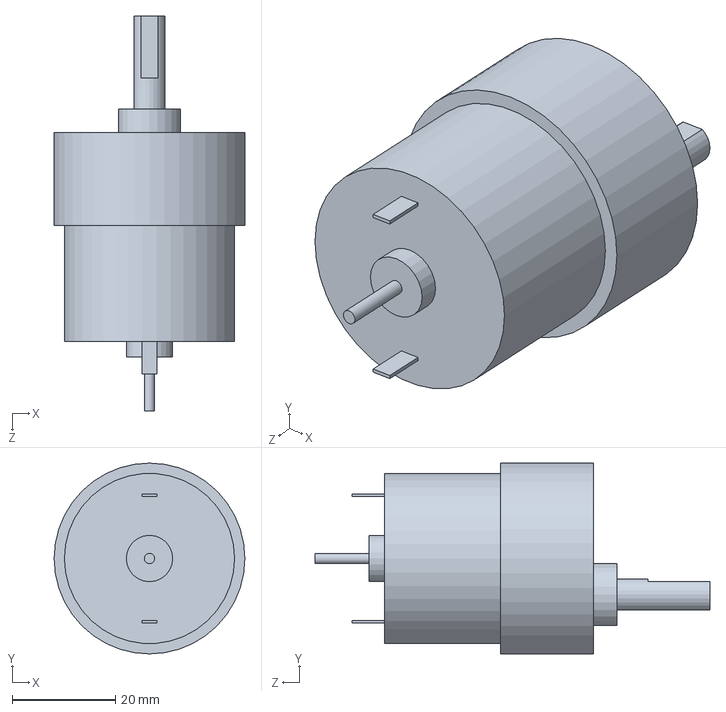
[picture p115: CAD file, 2014-05-18]
SolidWorks/Motor Hsiang Neng.SLDPRT
37.0 x 37.0 x 76.6 mm
