Guasch5000/RosPiBot/SolidWorks/Coupling.SLDPRT

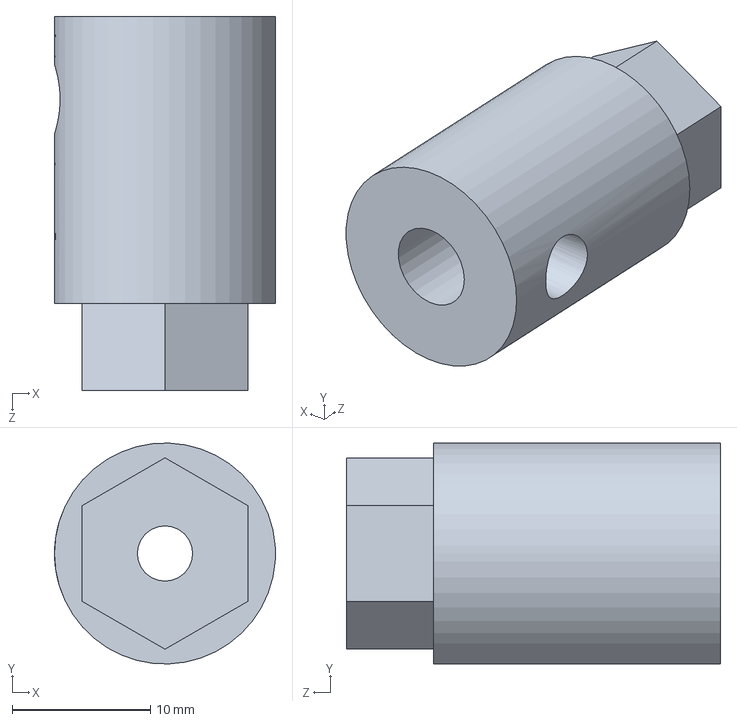
[picture p116: CAD file, 2014-05-18]
SolidWorks/Coupling.SLDPRT
16.0 x 16.0 x 27.1 mm
