Guasch5000/RosPiBot/SolidWorks/Switch.SLDPRT

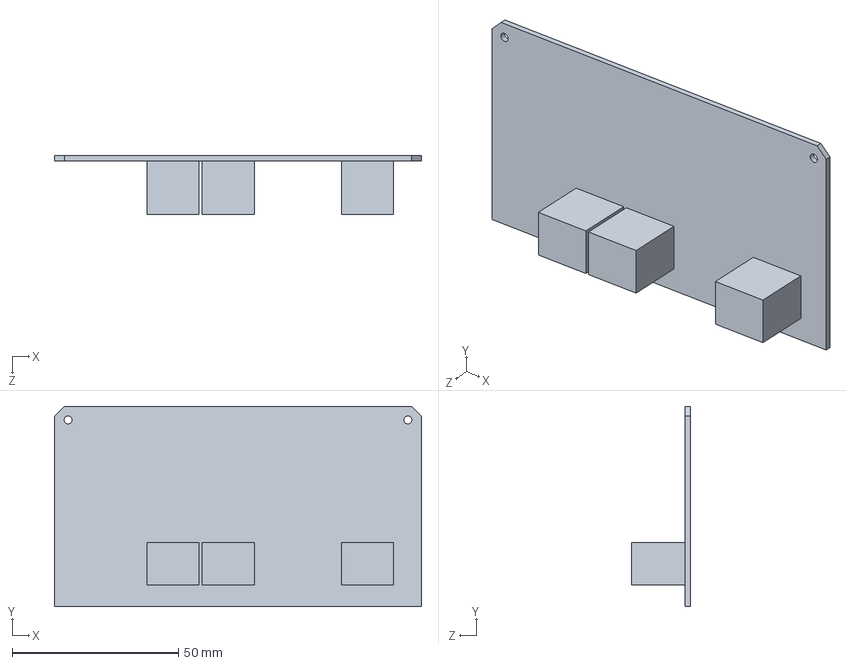
[picture p117: CAD file, 2014-05-18]
SolidWorks/Switch.SLDPRT
110.4 x 60.3 x 17.6 mm
