Guasch5000/RosPiBot/SolidWorks/soporte drivers derecho.SLDPRT

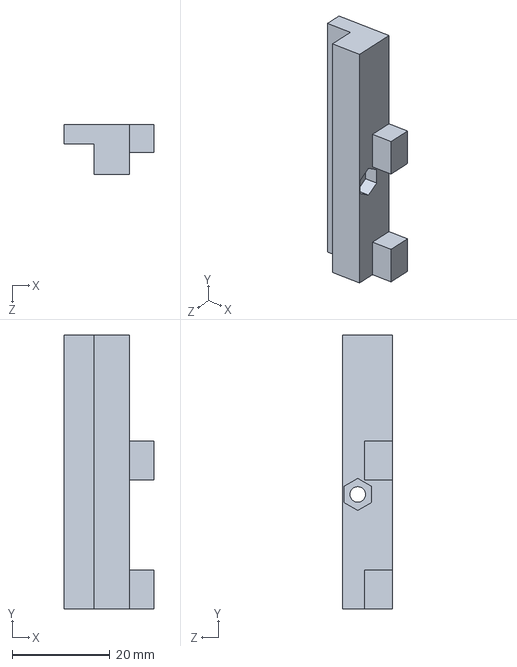
[picture p118: CAD file, 2014-05-18]
SolidWorks/soporte drivers derecho.SLDPRT
18.5 x 56.2 x 10.2 mm
