Guasch5000/RosPiBot/SolidWorks/RaspiCam.SLDPRT

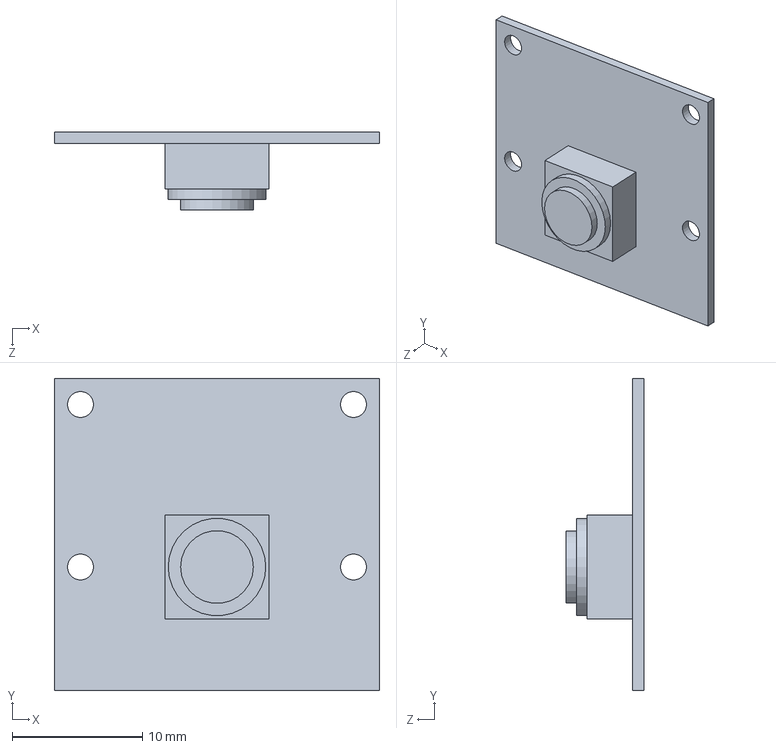
[picture p120: CAD file, 2014-05-18]
SolidWorks/RaspiCam.SLDPRT
25.0 x 24.0 x 6.00 mm
