Guasch5000/RosPiBot/SolidWorks/Sonar KS103.SLDPRT

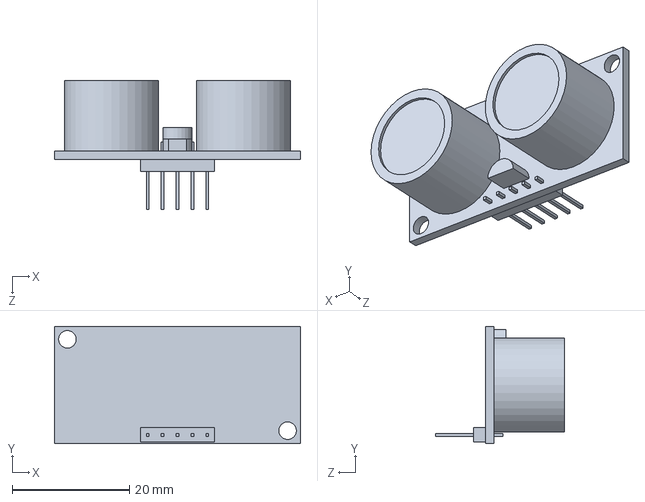
[picture p121: CAD file, 2014-05-18]
SolidWorks/Sonar KS103.SLDPRT
42.0 x 20.0 x 22.0 mm
