Guasch5000/RosPiBot/(list of files, cad)

Other CAD files:
SolidWorks/Rueda Izquierda.SLDASM
SolidWorks/tapa lateral exterior izquierda.SLDPRT
SolidWorks/tapa lateral interior derecha.SLDPRT
SolidWorks/tapa inferior.SLDPRT
SolidWorks/tapa.SLDPRT
SolidWorks/soporte escuadras izquierdas.SLDPRT
SolidWorks/tapa lateral interior izquierda.SLDPRT
SolidWorks/soporte trasero derecho uno.SLDPRT
SolidWorks/Etehrnet panel mount.SLDPRT
SolidWorks/Lateral izquierdo externo placa test.SLDPRT
SolidWorks/Drawings/Ensamblaje escuadra.SLDDRW
SolidWorks/Drawings/Panel delantero derecho.SLDDRW
SolidWorks/Drawings/Panel delantero izquierdo.SLDDRW
SolidWorks/Drawings/panel trasero derecho.SLDDRW
SolidWorks/Drawings/panel trasero izquierdo.SLDDRW
SolidWorks/Drawings/tapa inferior.SLDDRW
SolidWorks/Drawings/tapa lateral exterior derecha.SLDDRW
SolidWorks/Drawings/tapa lateral exterior izquierda.SLDDRW
SolidWorks/Drawings/tapa lateral interior derecha.SLDDRW
