Guasch5000/RosPiBot/SolidWorks/PDF/panel delantero derecho con cotas.PDF

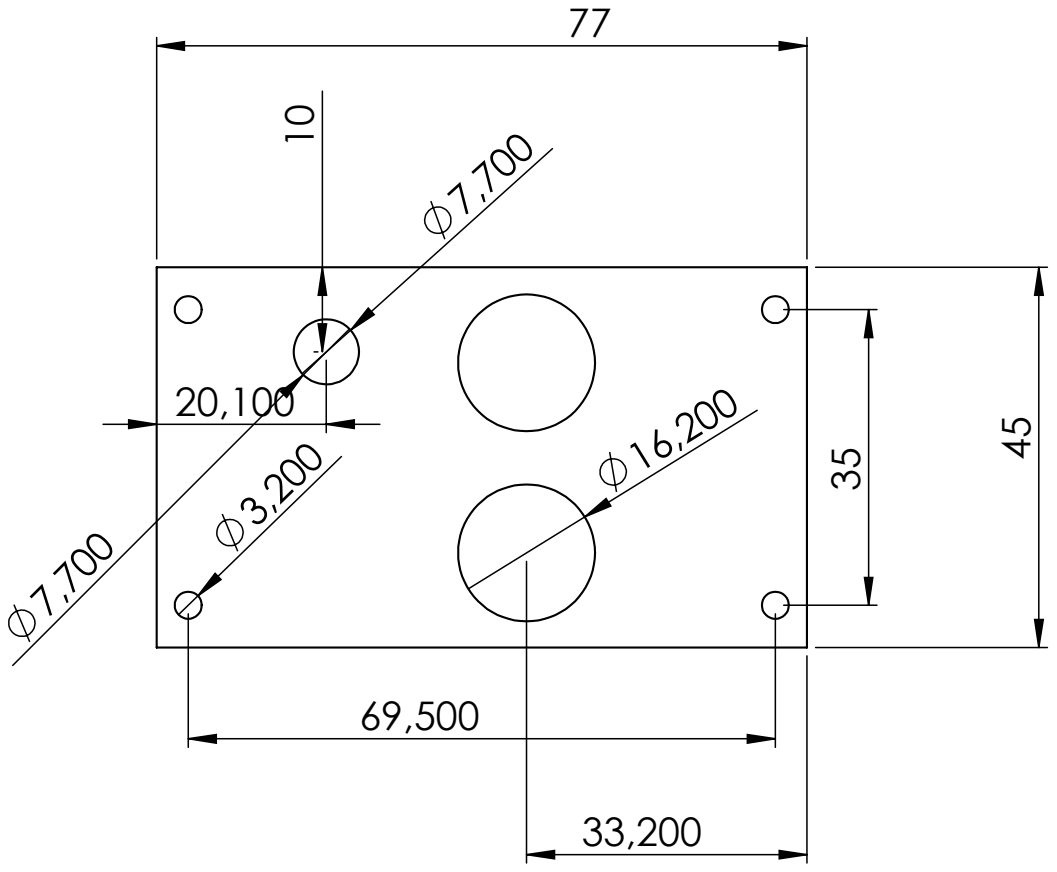
[picture p122: page 1]
