Guasch5000/RosPiBot/SolidWorks/PDF/panel delantero derecho sin cotas.PDF

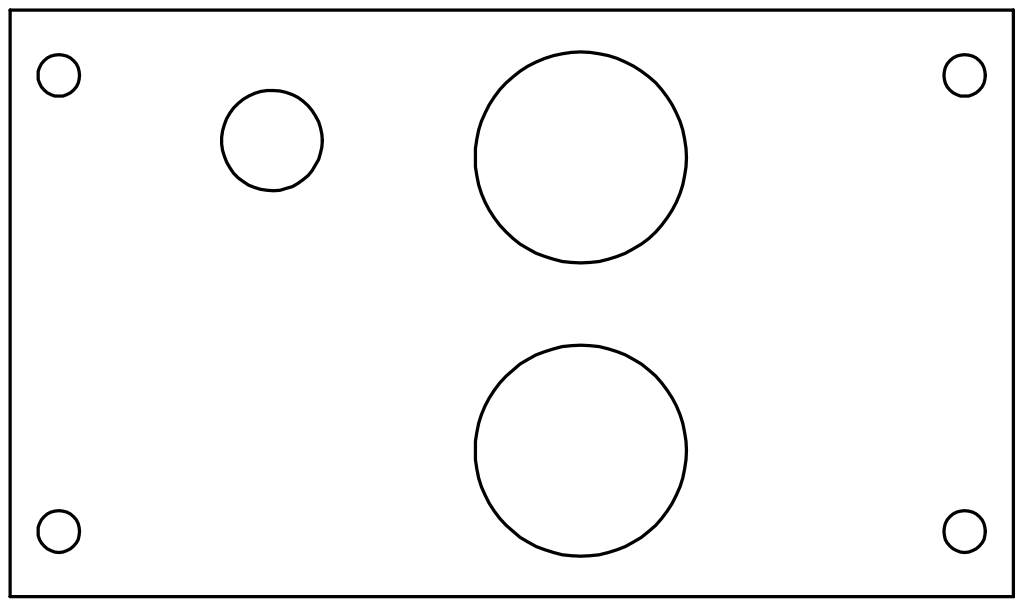
[picture p123: page 1]
