Guasch5000/RosPiBot/SolidWorks/PDF/panel delantero izquierdo con cotas.PDF

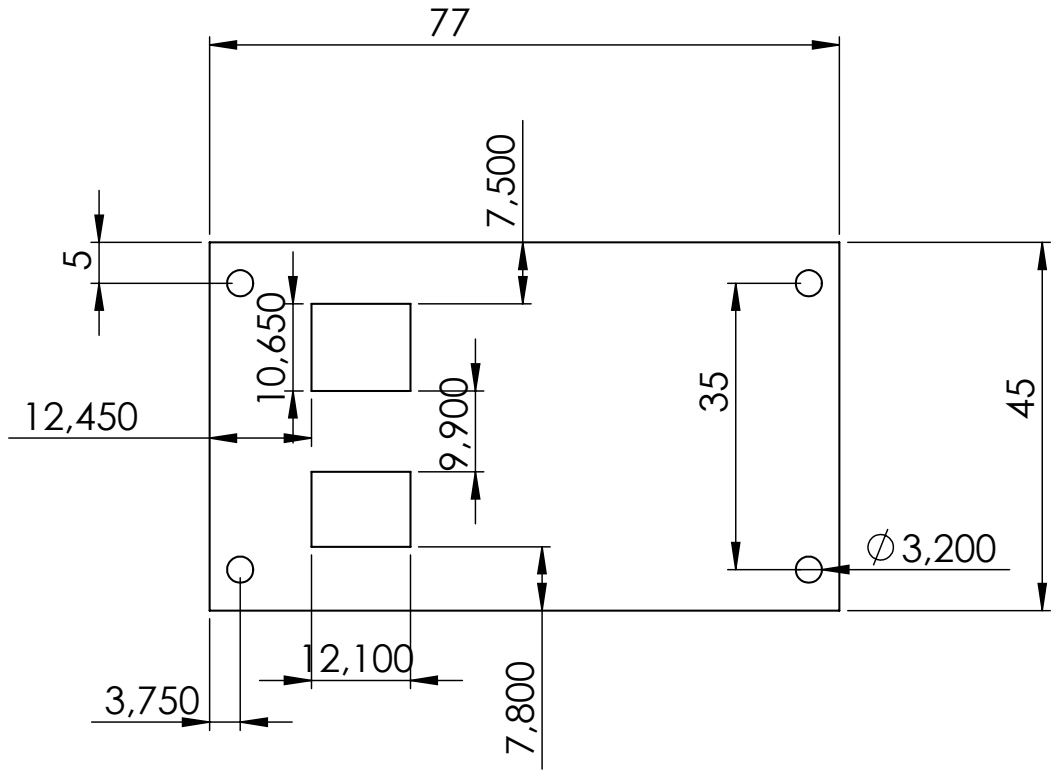
[picture p124: page 1]
