Guasch5000/RosPiBot/SolidWorks/PDF/panel delantero izquierdo sin cotas.PDF

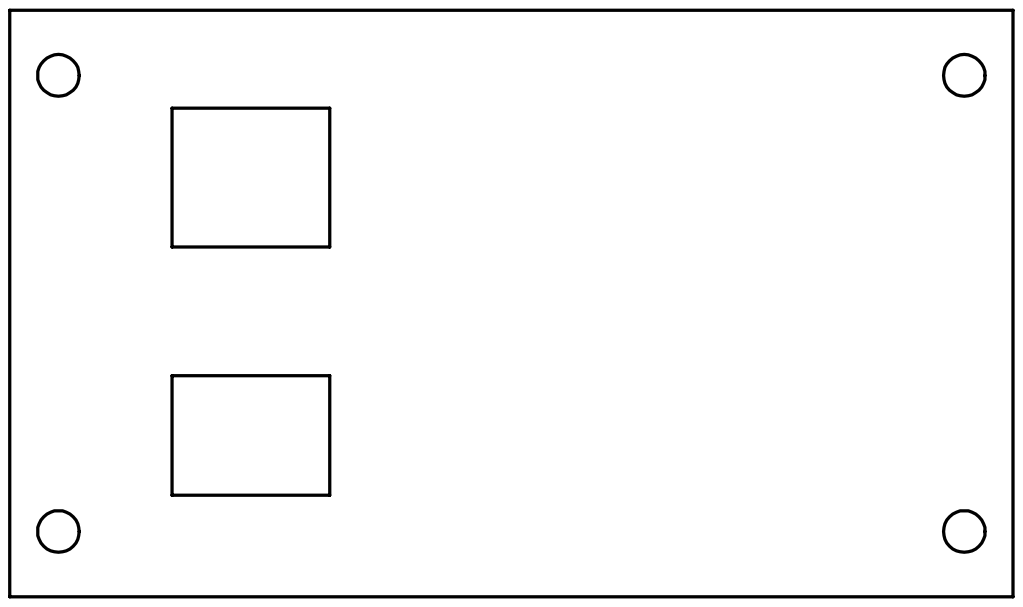
[picture p125: page 1]
