Guasch5000/RosPiBot/SolidWorks/PDF/panel trasero derecho con cotas.PDF

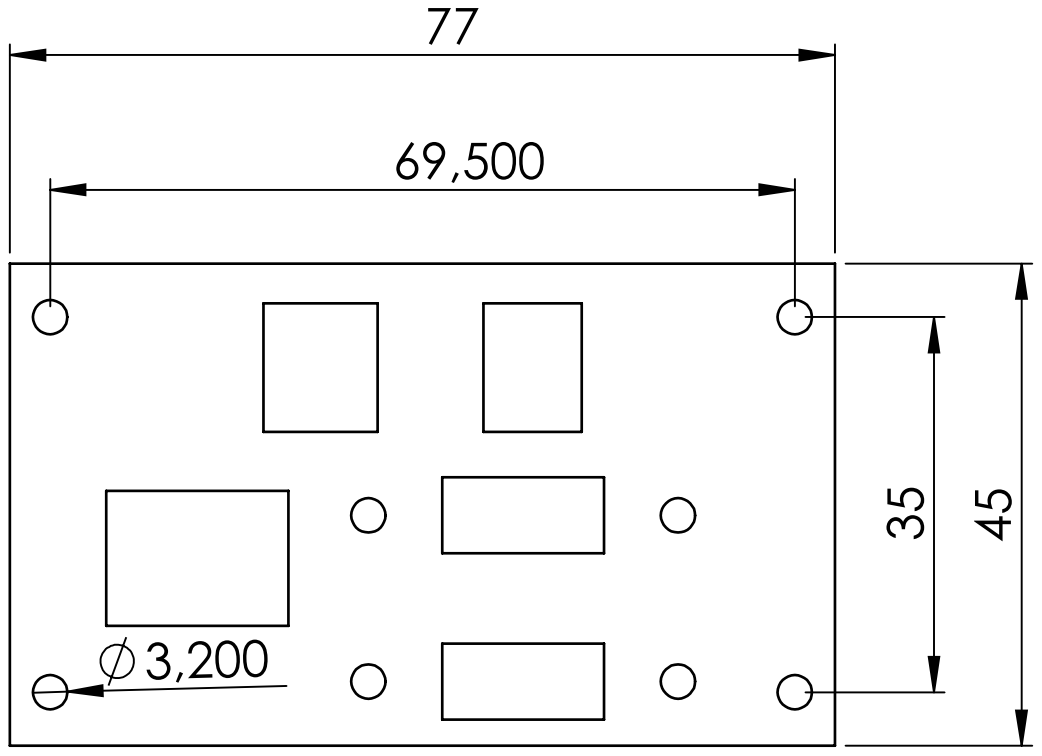
[picture p126: page 1]
