Guasch5000/RosPiBot/SolidWorks/PDF/panel trasero derecho sin cotas.PDF

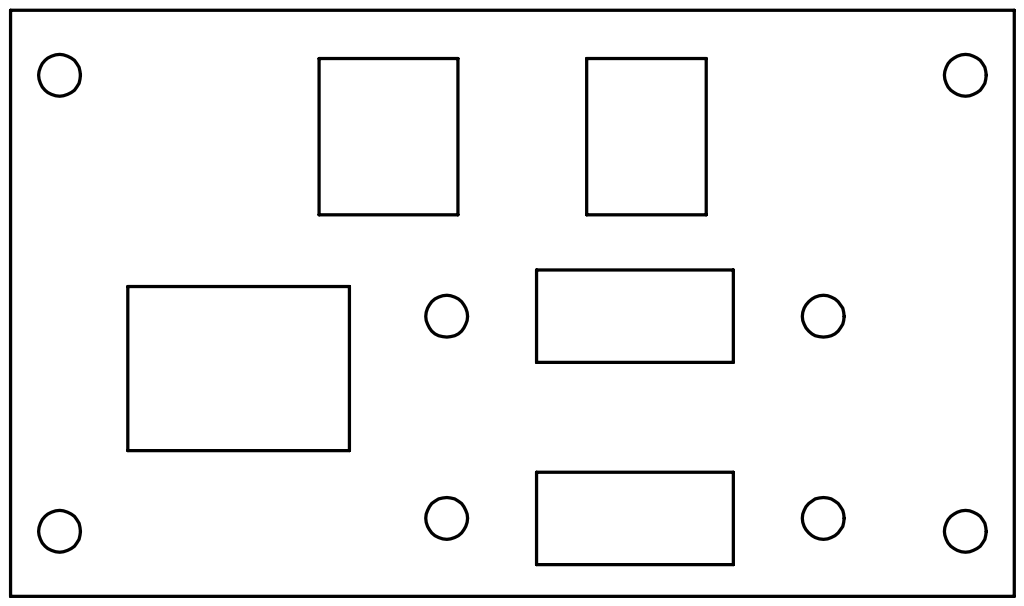
[picture p127: page 1]
