Guasch5000/RosPiBot/SolidWorks/PDF/panel trasero izquierdo con cotas.PDF

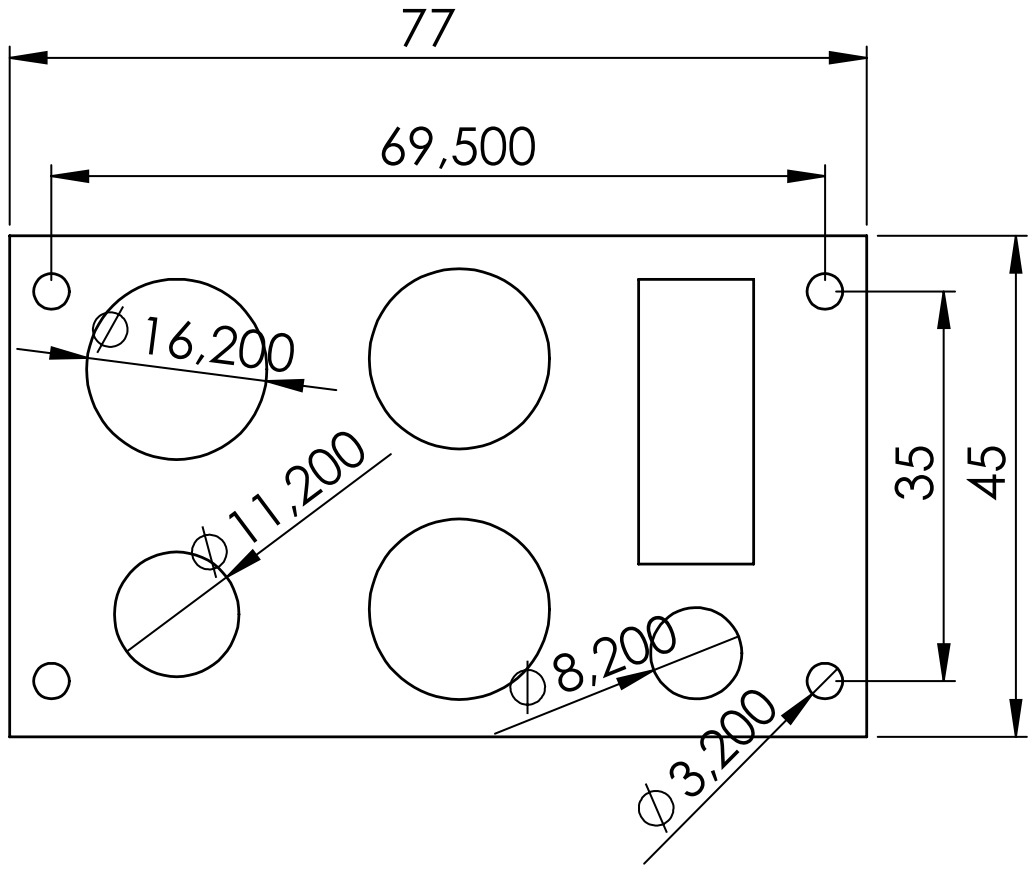
[picture p128: page 1]
