Guasch5000/RosPiBot/SolidWorks/PDF/panel trasero izquierdo sin cotas.PDF

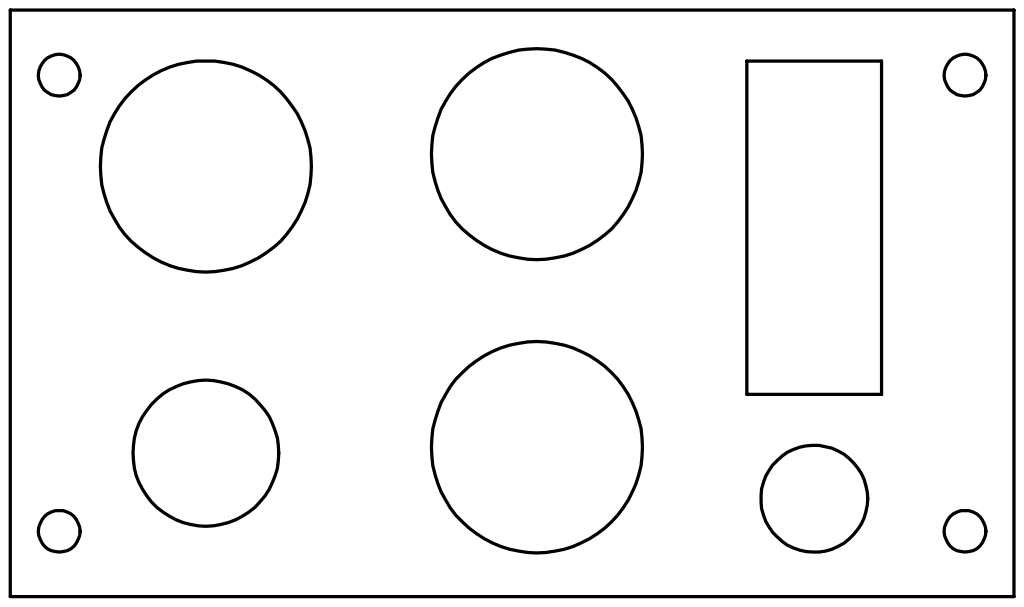
[picture p129: page 1]
