Guasch5000/RosPiBot/SolidWorks/PDF/tapa  izquierda sin cotas.PDF

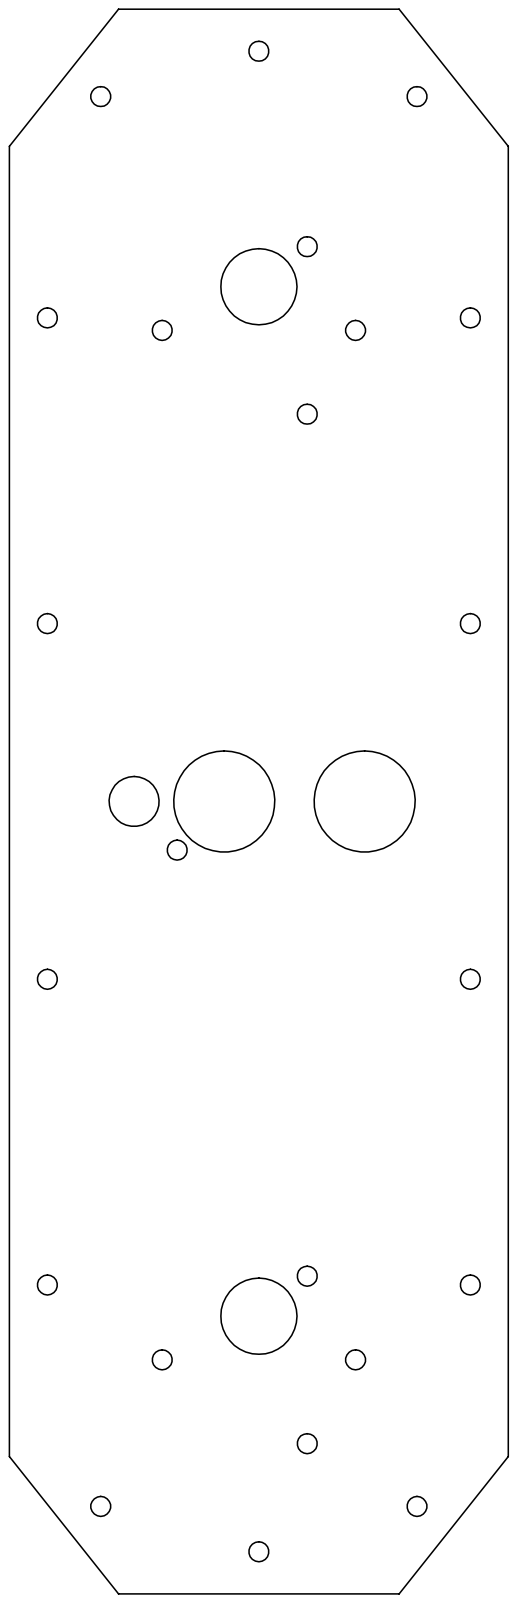
[picture p130: page 1]
