Guasch5000/RosPiBot/SolidWorks/PDF/tapa derecha con cotas.PDF

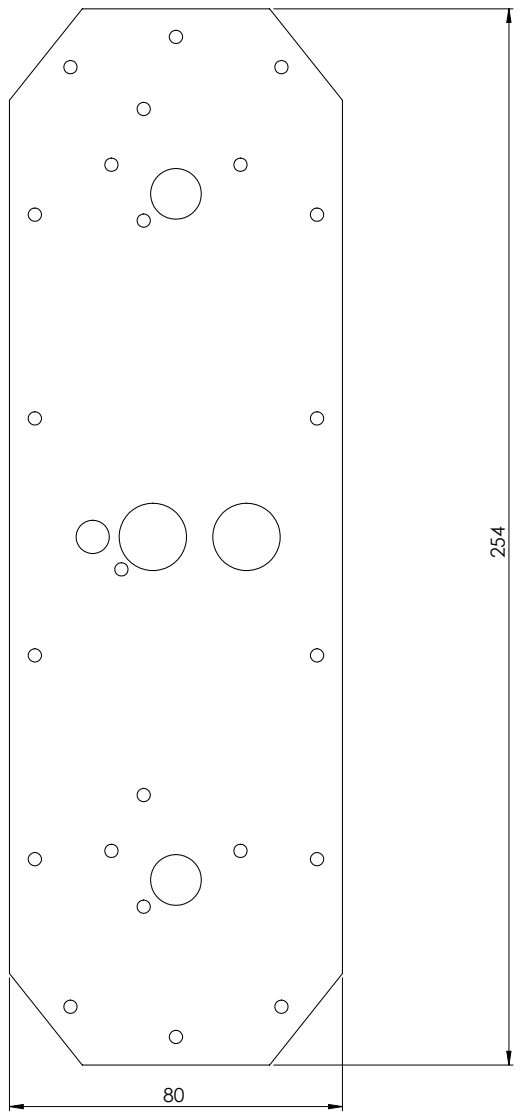
[picture p131: page 1]
