Guasch5000/RosPiBot/SolidWorks/PDF/tapa derecha sin cotas.PDF

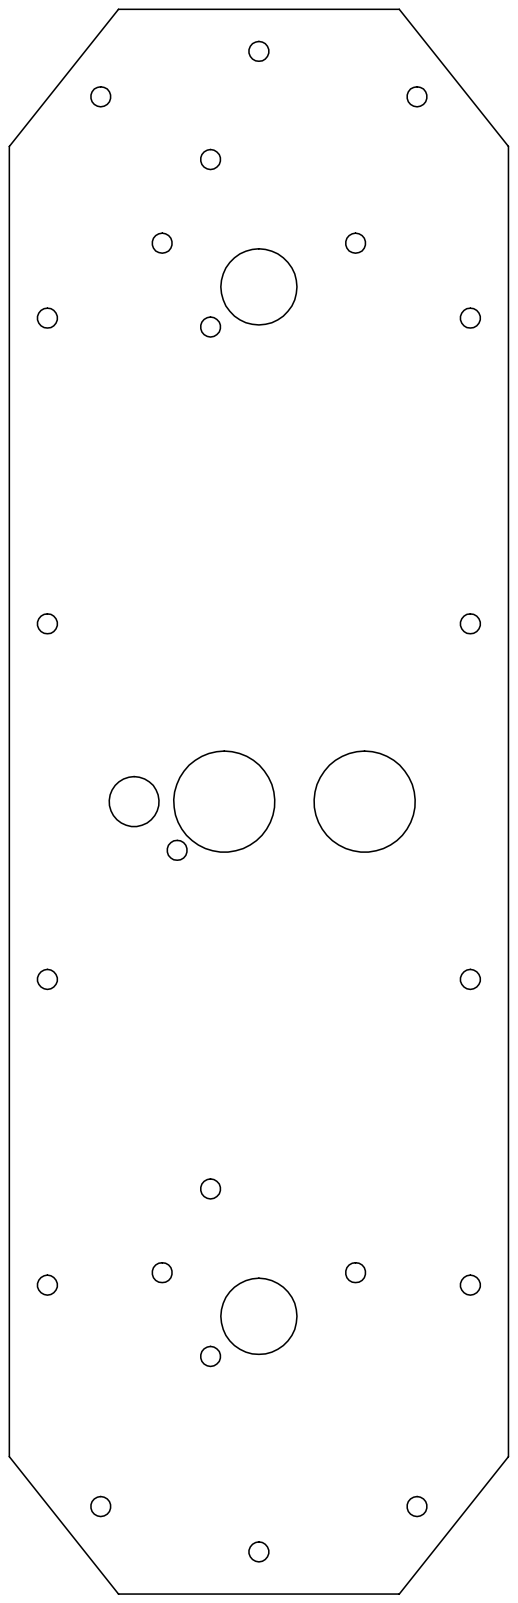
[picture p132: page 1]
