Guasch5000/RosPiBot/SolidWorks/PDF/tapa escuadra con cotas.PDF

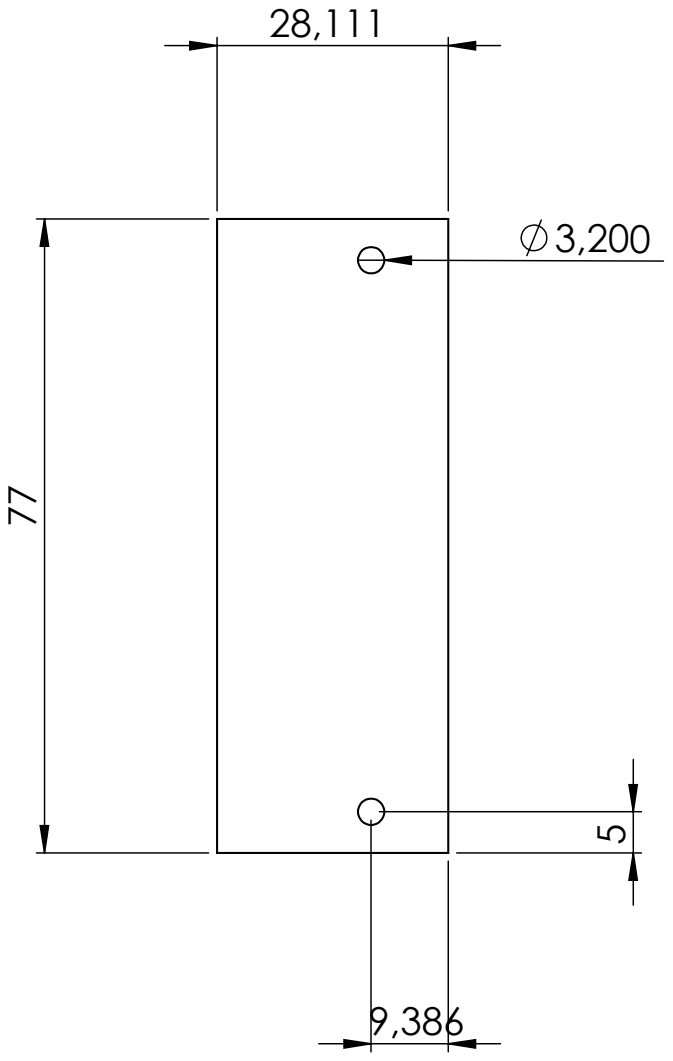
[picture p133: page 1]
