Guasch5000/RosPiBot/SolidWorks/PDF/tapa escuadra sin cotas.PDF

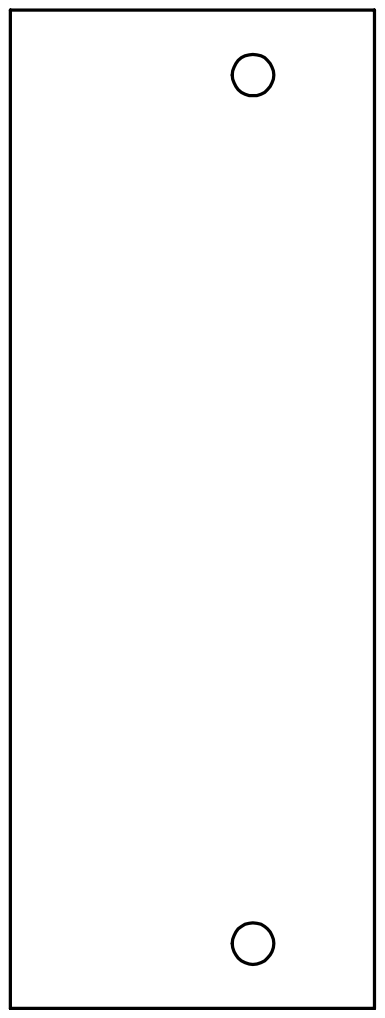
[picture p134: page 1]
