Guasch5000/RosPiBot/SolidWorks/PDF/tapa horizontal con cotas.PDF

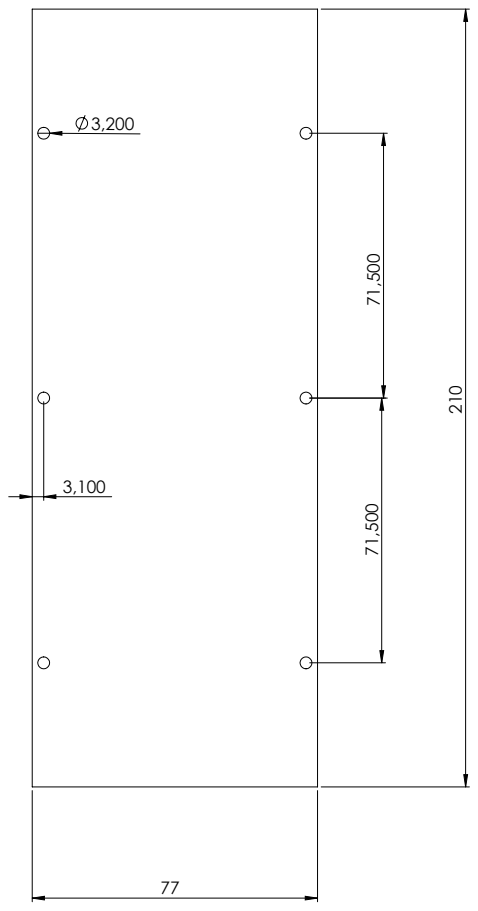
[picture p135: page 1]
