Guasch5000/RosPiBot/SolidWorks/PDF/tapa horizontal sin cotas.PDF

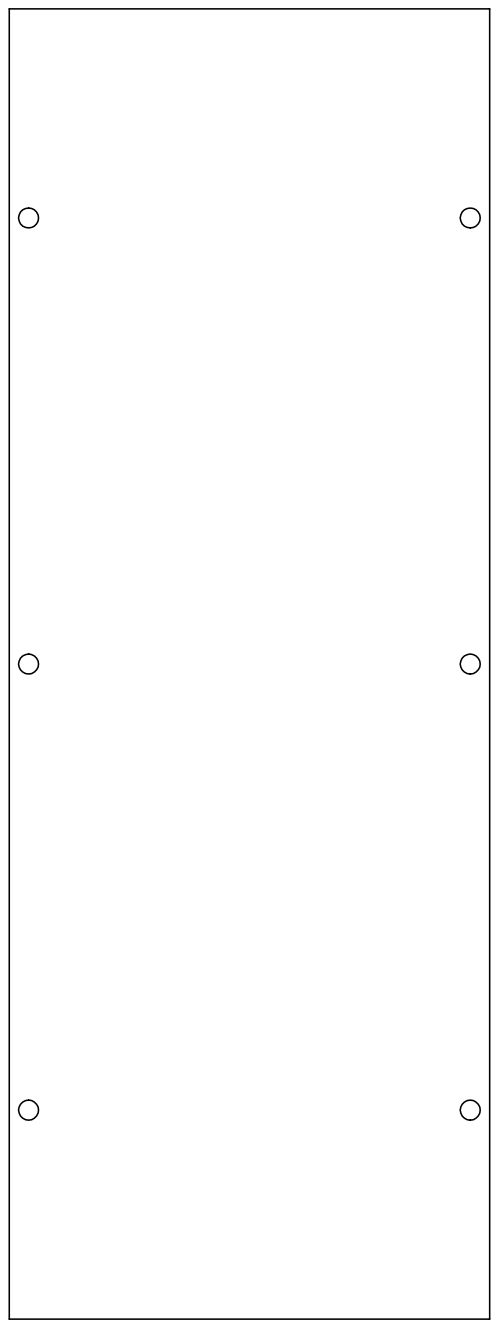
[picture p136: page 1]
