Guasch5000/RosPiBot/SolidWorks/PDF/tapa interior con cotas.PDF

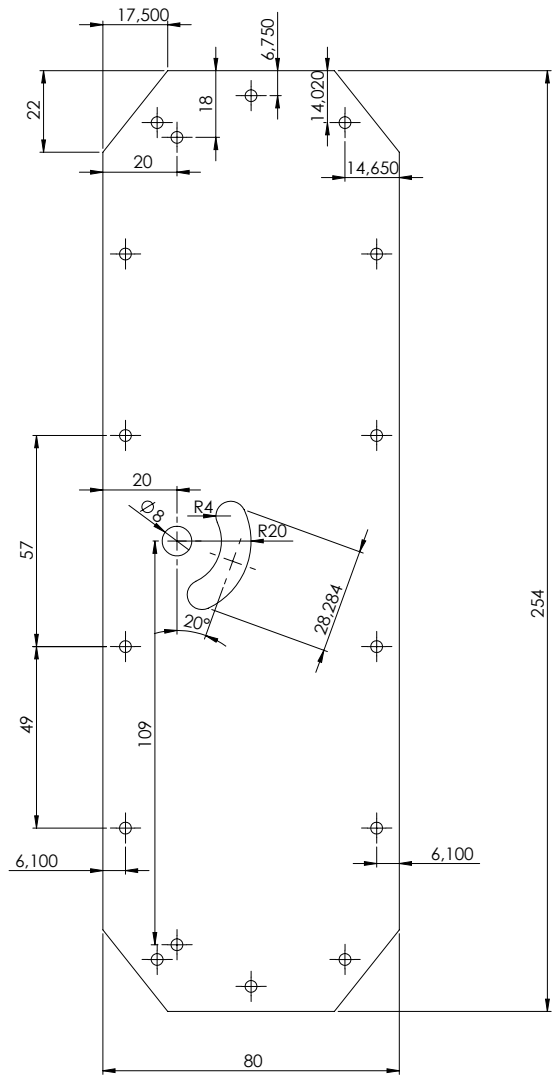
[picture p137: page 1]
