Guasch5000/RosPiBot/SolidWorks/PDF/tapa interior sin cotas.PDF

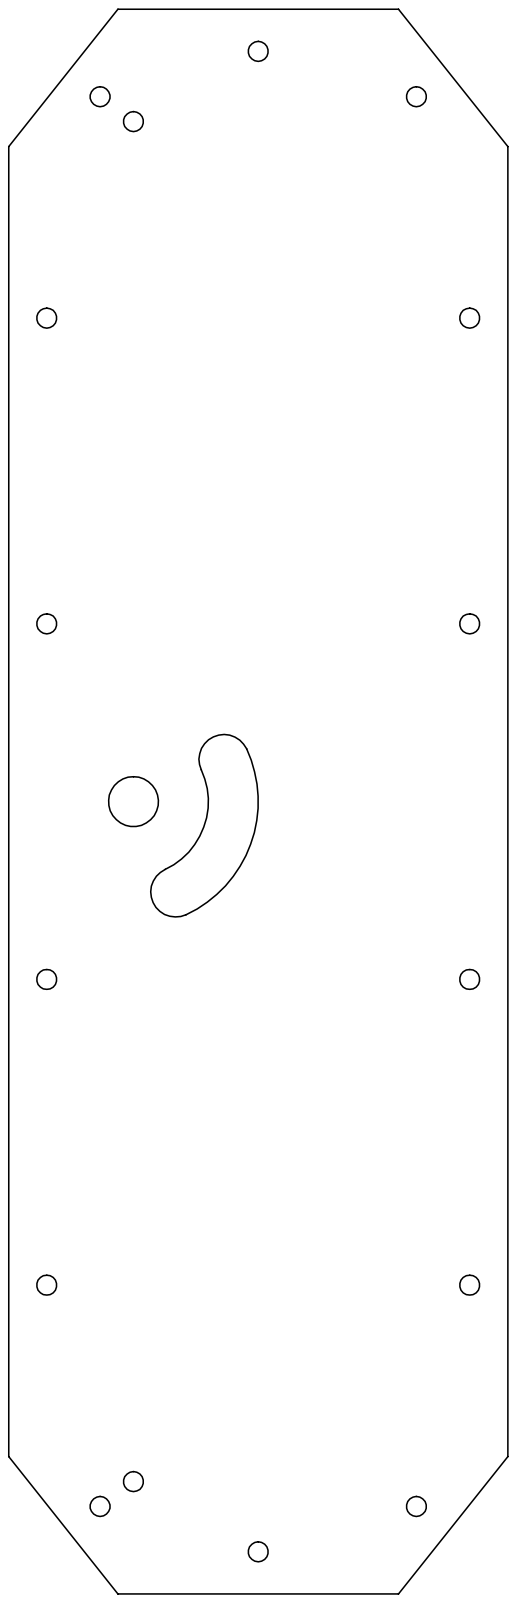
[picture p138: page 1]
