Guasch5000/RosPiBot/SolidWorks/PDF/tapa izquierda con cotas.PDF

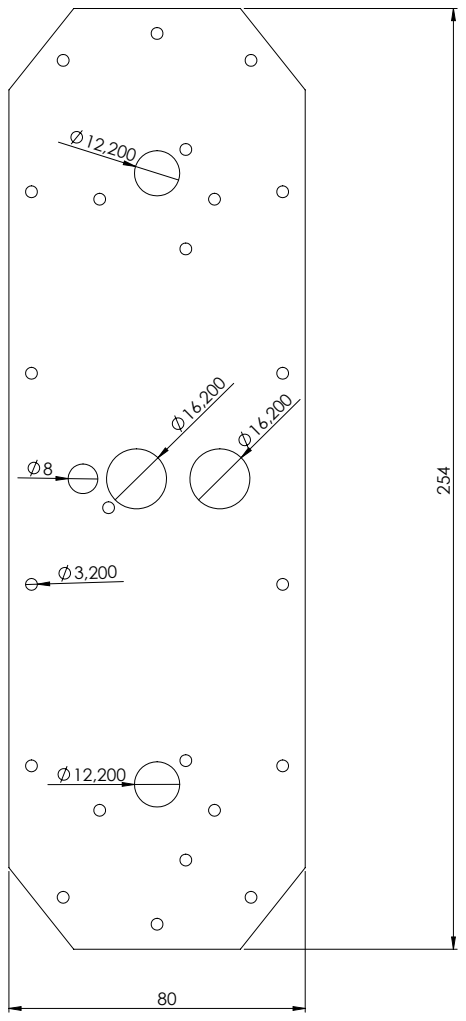
[picture p139: page 1]
