Guasch5000/RosPiBot/Kicad/SensorPi _Board/SensorPi.kicad_pcb

## KiCad design Kicad/SensorPi _Board/SensorPi.kicad_pcb (2014-03-10)

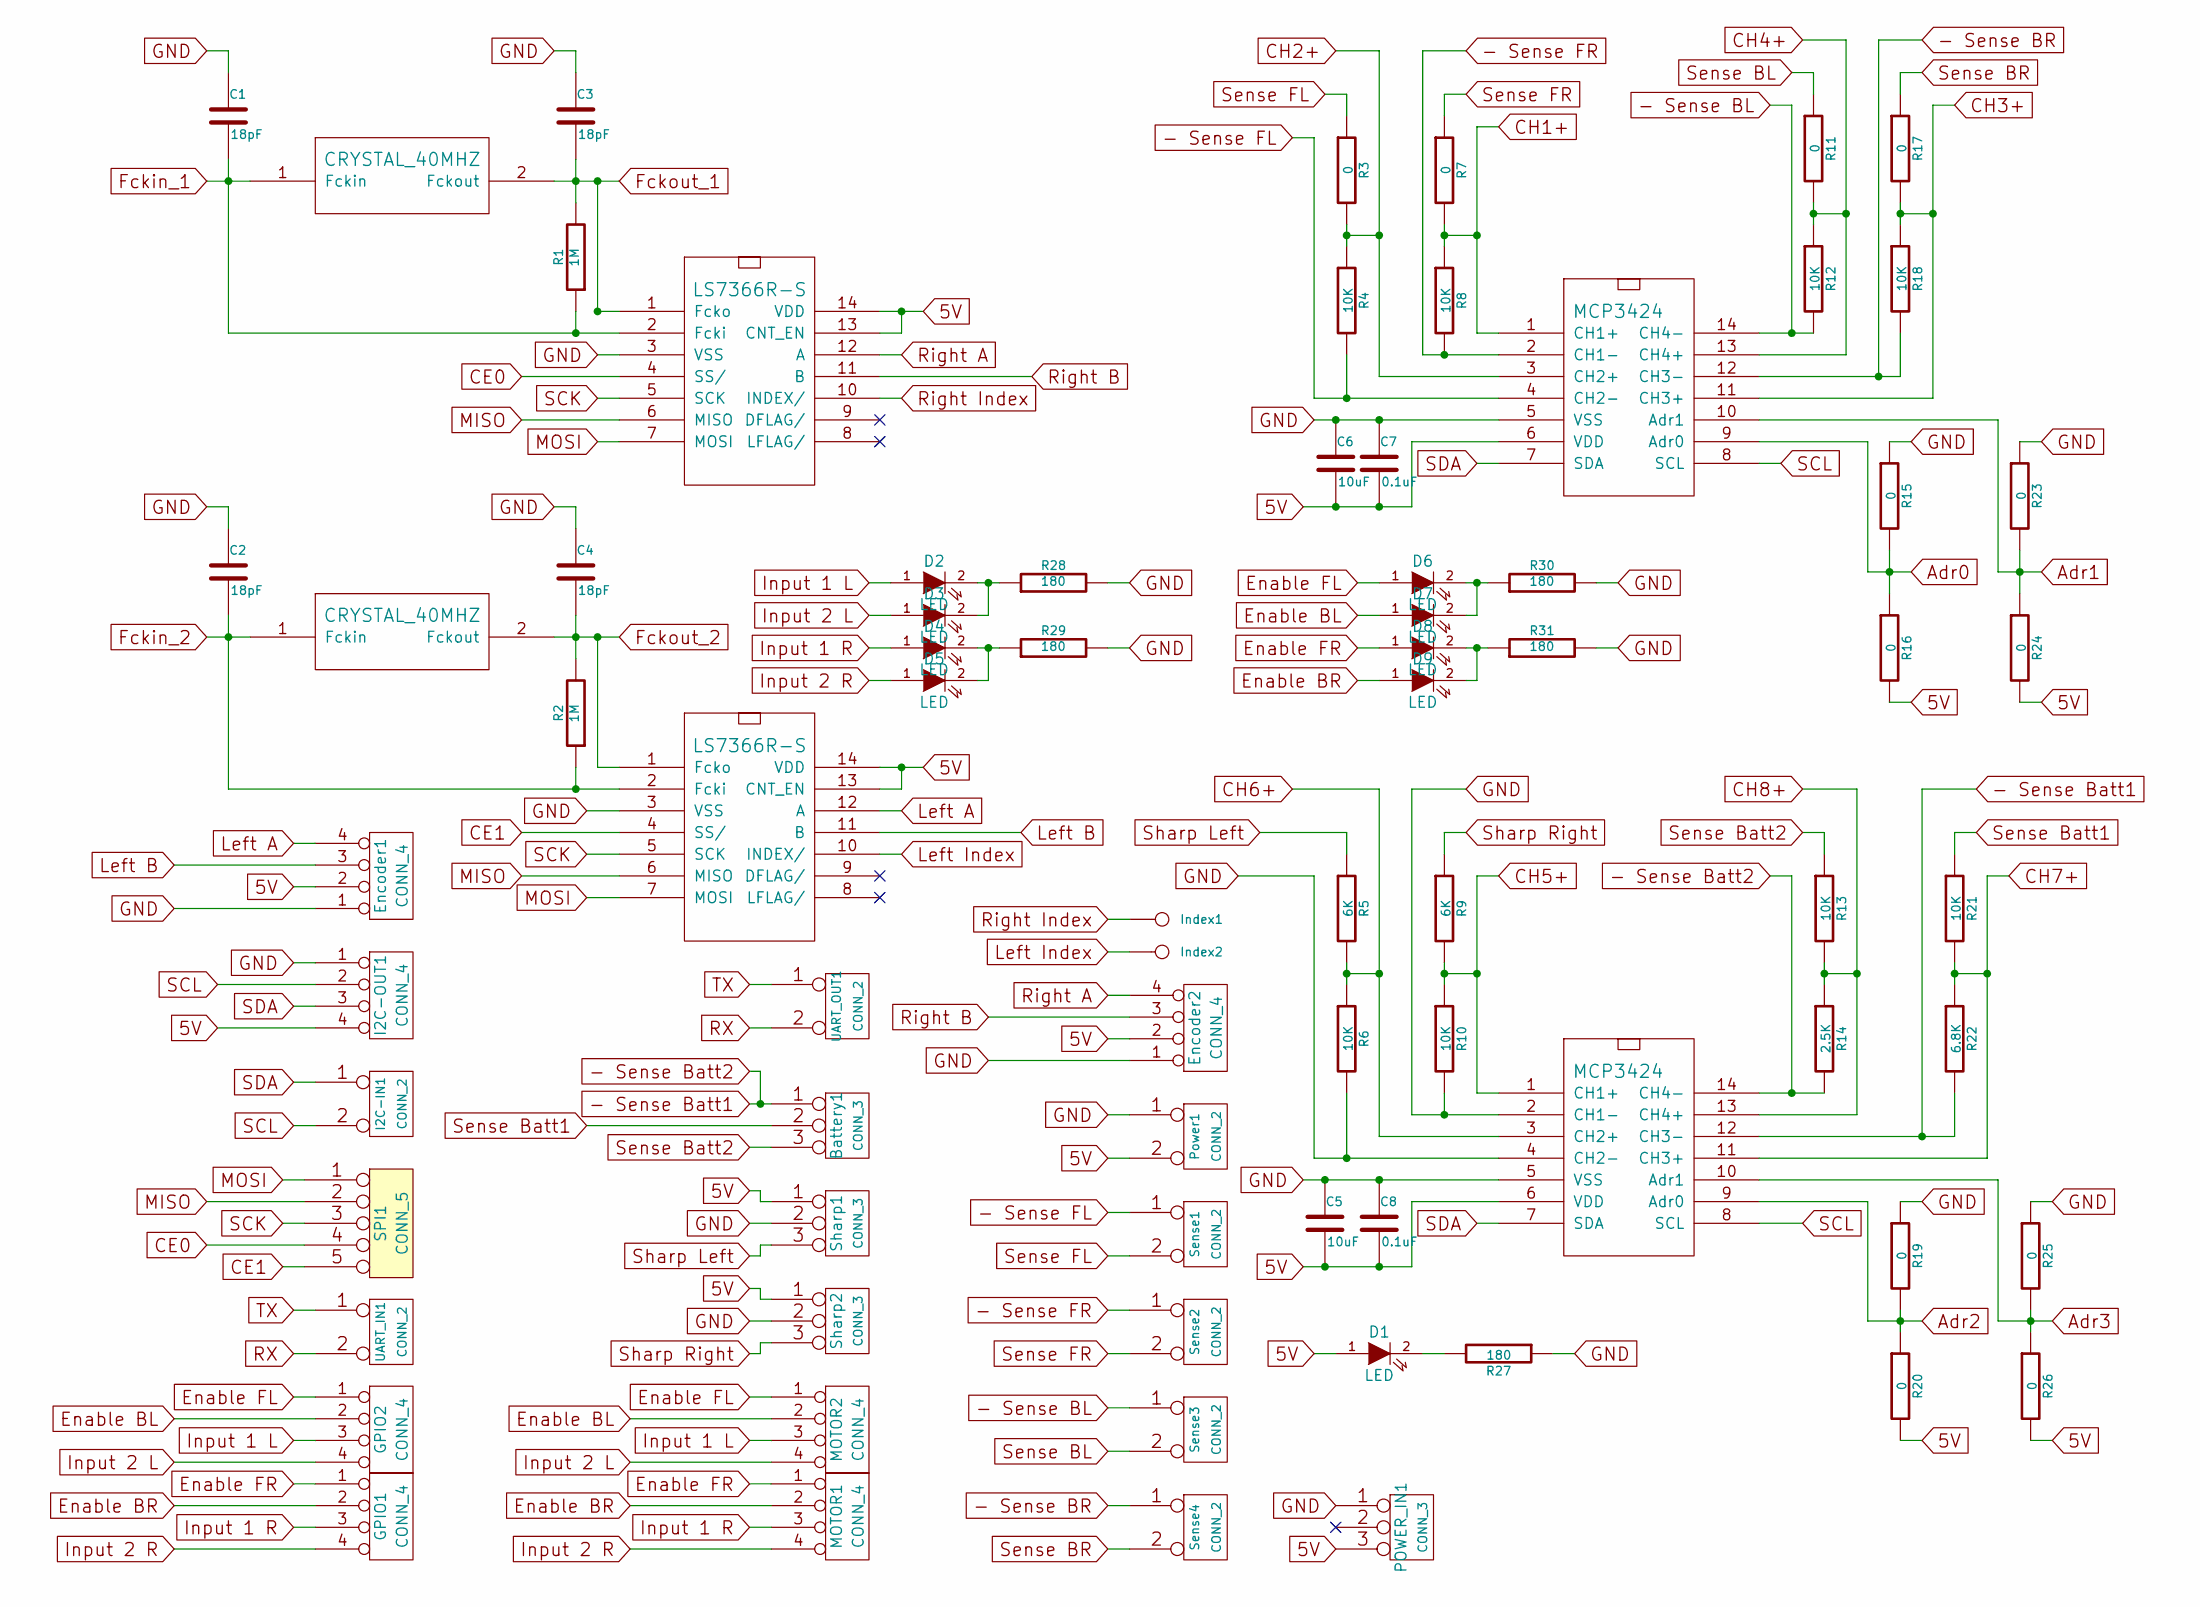
[picture p140: schematic SensorPi.sch]

Parts:
Battery1: CONN_3
C1, C2, C3, C4: 18pF
C5, C6: 10uF
C7, C8: 0.1uF
D1, D2, D3, D4, D5, D6, D7, D8, D9: LED
Encoder1, Encoder2: CONN_4
GPIO1, GPIO2: CONN_4
I2C-IN1: CONN_2
I2C-OUT1: CONN_4
Index1, Index2: CONN_1
MOTOR1, MOTOR2: CONN_4
POWER_IN1: CONN_3
Power1: CONN_2
R1, R2: 1M
R3, R7, R11, R15, R16, R17, R19, R20, R23, R24, R25, R26: 0
R4, R6, R8, R10, R12, R13, R18, R21: 10K
R5, R9: 6K
R14: 2.5K
R22: 6.8K
R27, R28, R29, R30, R31: 180
SMD1, SMD2: CRYSTAL_40MHZ
SOIC1, SOIC2: LS7366R-S
SOIC_1, SOIC_2: MCP3424
SPI1: CONN_5
Sense1, Sense2, Sense3, Sense4: CONN_2
Sharp1, Sharp2: CONN_3
UART_IN1: CONN_2
UART_OUT1: CONN_2

Connections:
5V: C5.2, C6.2, C7.2, C8.2, D1.1 (A), Encoder1.2, Encoder2.2, I2C-OUT1.4, POWER_IN1.3, Power1.2 (PM), R16.2, R20.2, R24.2, R26.2, SOIC1.13 (CNT_EN), SOIC1.14 (VDD), SOIC2.13 (CNT_EN), SOIC2.14 (VDD), SOIC_1.6 (VDD), SOIC_2.6 (VDD), Sharp1.1, Sharp2.1; also elsewhere on the board
- Sense BL: R12.2, SOIC_1.14 (CH4-), Sense3.1
- Sense BR: R18.2, SOIC_1.12 (CH3-), Sense4.1
- Sense Batt1: Battery1.1, R14.2, R22.2, SOIC_2.12 (CH3-), SOIC_2.14 (CH4-)
- Sense FL: R4.2, SOIC_1.4 (CH2-), Sense1.1
- Sense FR: R8.2, SOIC_1.2 (CH1-), Sense2.1
Adr0: R15.2, R16.1, SOIC_1.9 (Adr0)
Adr1: R23.2, R24.1, SOIC_1.10 (Adr1)
Adr2: R19.2, R20.1, SOIC_2.9 (Adr0)
Adr3: R25.2, R26.1, SOIC_2.10 (Adr1)
CE0: SOIC1.4 (SS/), SPI1.4
CE1: SOIC2.4 (SS/), SPI1.5
CH1+: R7.2, R8.1, SOIC_1.1 (CH1+)
CH2+: R3.2, R4.1, SOIC_1.3 (CH2+)
CH3+: R17.2, R18.1, SOIC_1.11 (CH3+)
CH4+: R11.2, R12.1, SOIC_1.13 (CH4+)
CH5+: R9.2, R10.1, SOIC_2.1 (CH1+)
CH6+: R5.2, R6.1, SOIC_2.3 (CH2+)
CH7+: R21.2, R22.1, SOIC_2.11 (CH3+)
CH8+: R13.2, R14.1, SOIC_2.13 (CH4+)
Enable BL: D7.1 (A), GPIO2.2, MOTOR2.2
Enable BR: D9.1 (A), GPIO1.2, MOTOR1.2
Enable FL: D6.1 (A), GPIO2.1, MOTOR2.1
Enable FR: D8.1 (A), GPIO1.1, MOTOR1.1
Fckin_1: C1.2, R1.1, SMD1.1 (Fckin), SOIC1.2 (Fcki)
Fckin_2: C2.2, R2.1, SMD2.1 (Fckin), SOIC2.2 (Fcki)
Fckout_1: C3.2, R1.2, SMD1.2 (Fckout), SOIC1.1 (Fcko)
Fckout_2: C4.2, R2.2, SMD2.2 (Fckout), SOIC2.1 (Fcko)
GND: C1.1, C2.1, C3.1, C4.1, C5.1, C6.1, C7.1, C8.1, Encoder1.1, Encoder2.1, I2C-OUT1.1, POWER_IN1.1, Power1.1, R6.2, R10.2, R15.1, R19.1, R23.1, R25.1, R27.1, R28.2, R29.2, R30.2, R31.2, SOIC1.3 (VSS), SOIC2.3 (VSS), SOIC_1.5 (VSS), SOIC_2.2 (CH1-), SOIC_2.4 (CH2-), SOIC_2.5 (VSS), Sharp1.2 (PM), Sharp2.2 (PM); also elsewhere on the board
Input 1 L: D2.1 (A), GPIO2.3, MOTOR2.3
Input 1 R: D4.1 (A), GPIO1.3, MOTOR1.3
Input 2 L: D3.1 (A), GPIO2.4, MOTOR2.4
Input 2 R: D5.1 (A), GPIO1.4, MOTOR1.4
Left A: Encoder1.4, SOIC2.12 (A)
Left B: Encoder1.3, SOIC2.11 (B)
Left Index: Index2.1, SOIC2.10 (INDEX/)
MISO: SOIC1.6 (MISO), SOIC2.6 (MISO), SPI1.2
MOSI: SOIC1.7 (MOSI), SOIC2.7 (MOSI), SPI1.1
unnamed: D4.2 (K), D5.2 (K), R29.1
unnamed: D2.2 (K), D3.2 (K), R28.1
unnamed: D1.2 (K), R27.2
unnamed: D6.2 (K), D7.2 (K), R30.1
unnamed: D8.2 (K), D9.2 (K), R31.1
RX: UART_IN1.2 (PM), UART_OUT1.2 (PM); also elsewhere on the board
Right A: Encoder2.4, SOIC1.12 (A)
Right B: Encoder2.3, SOIC1.11 (B)
Right Index: Index1.1, SOIC1.10 (INDEX/)
SCK: SOIC1.5 (SCK), SOIC2.5 (SCK), SPI1.3
SCL: I2C-IN1.2 (PM), I2C-OUT1.2, SOIC_1.8 (SCL), SOIC_2.8 (SCL); also elsewhere on the board
SDA: I2C-IN1.1, I2C-OUT1.3, SOIC_1.7 (SDA), SOIC_2.7 (SDA); also elsewhere on the board
Sense BL: R11.1, Sense3.2 (PM)
Sense BR: R17.1, Sense4.2 (PM)
Sense Batt1: Battery1.2 (PM), R21.1
Sense Batt2: Battery1.3, R13.1
Sense FL: R3.1, Sense1.2 (PM)
Sense FR: R7.1, Sense2.2 (PM)
Sharp Left: R5.1, Sharp1.3
Sharp Right: R9.1, Sharp2.3
TX: UART_IN1.1, UART_OUT1.1; also elsewhere on the board

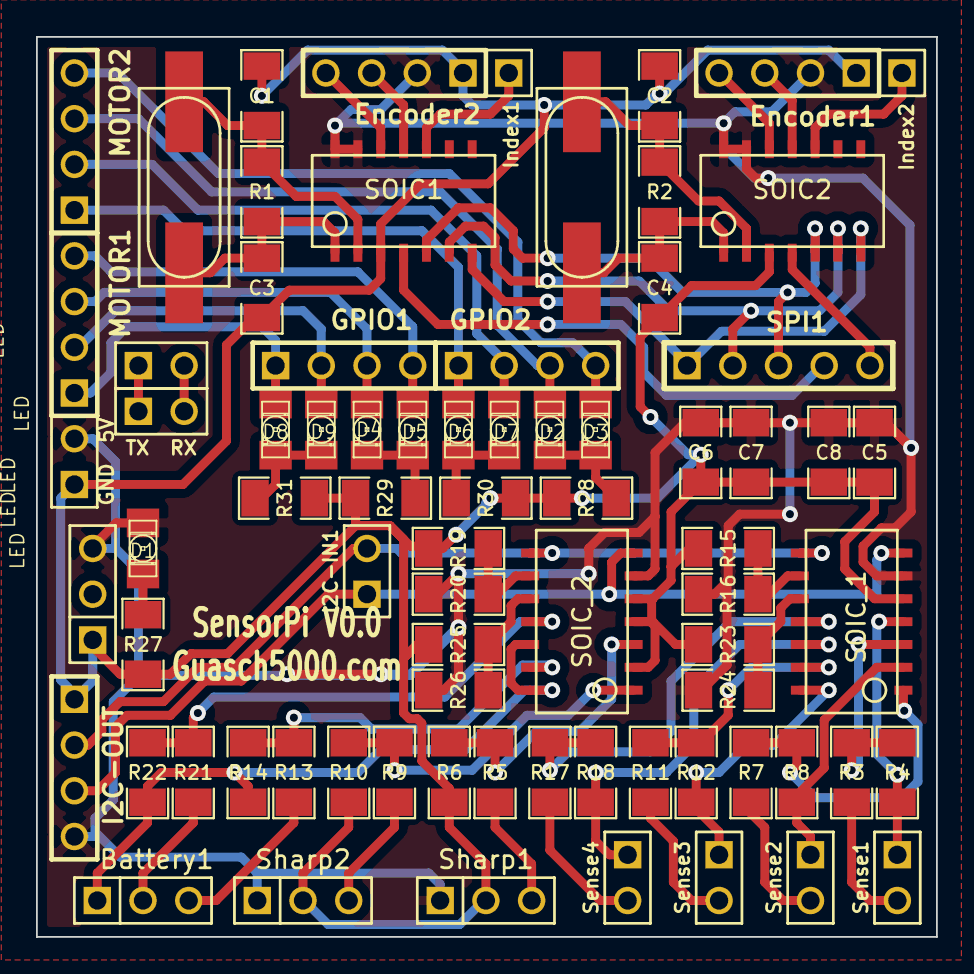
[picture p141: board SensorPi.kicad_pcb from above]

Board: 2 copper layers, 50.0 x 50.0 mm, 76 parts (0 on the bottom side), 59 nets.

Other parts of the board:
GND  5V: CONN_2; PIN_ARRAY_2X1
I2C-OUT: CONN_4; PIN_ARRAY_4x1
TX  RX: CONN_2; PIN_ARRAY_2X1

Their connections:
5V: GND 5V.2, I2C-OUT.4; also elsewhere on the board
GND: GND 5V.1, I2C-OUT.1; also elsewhere on the board
RX: TX RX.2; also elsewhere on the board
SCL: I2C-OUT.2; also elsewhere on the board
SDA: I2C-OUT.3; also elsewhere on the board
TX: TX RX.1; also elsewhere on the board
