Guasch5000/RosPiBot/Kicad/SecurePi_Board/securePi.kicad_pcb

## KiCad design Kicad/SecurePi_Board/securePi.kicad_pcb (2014-03-10)

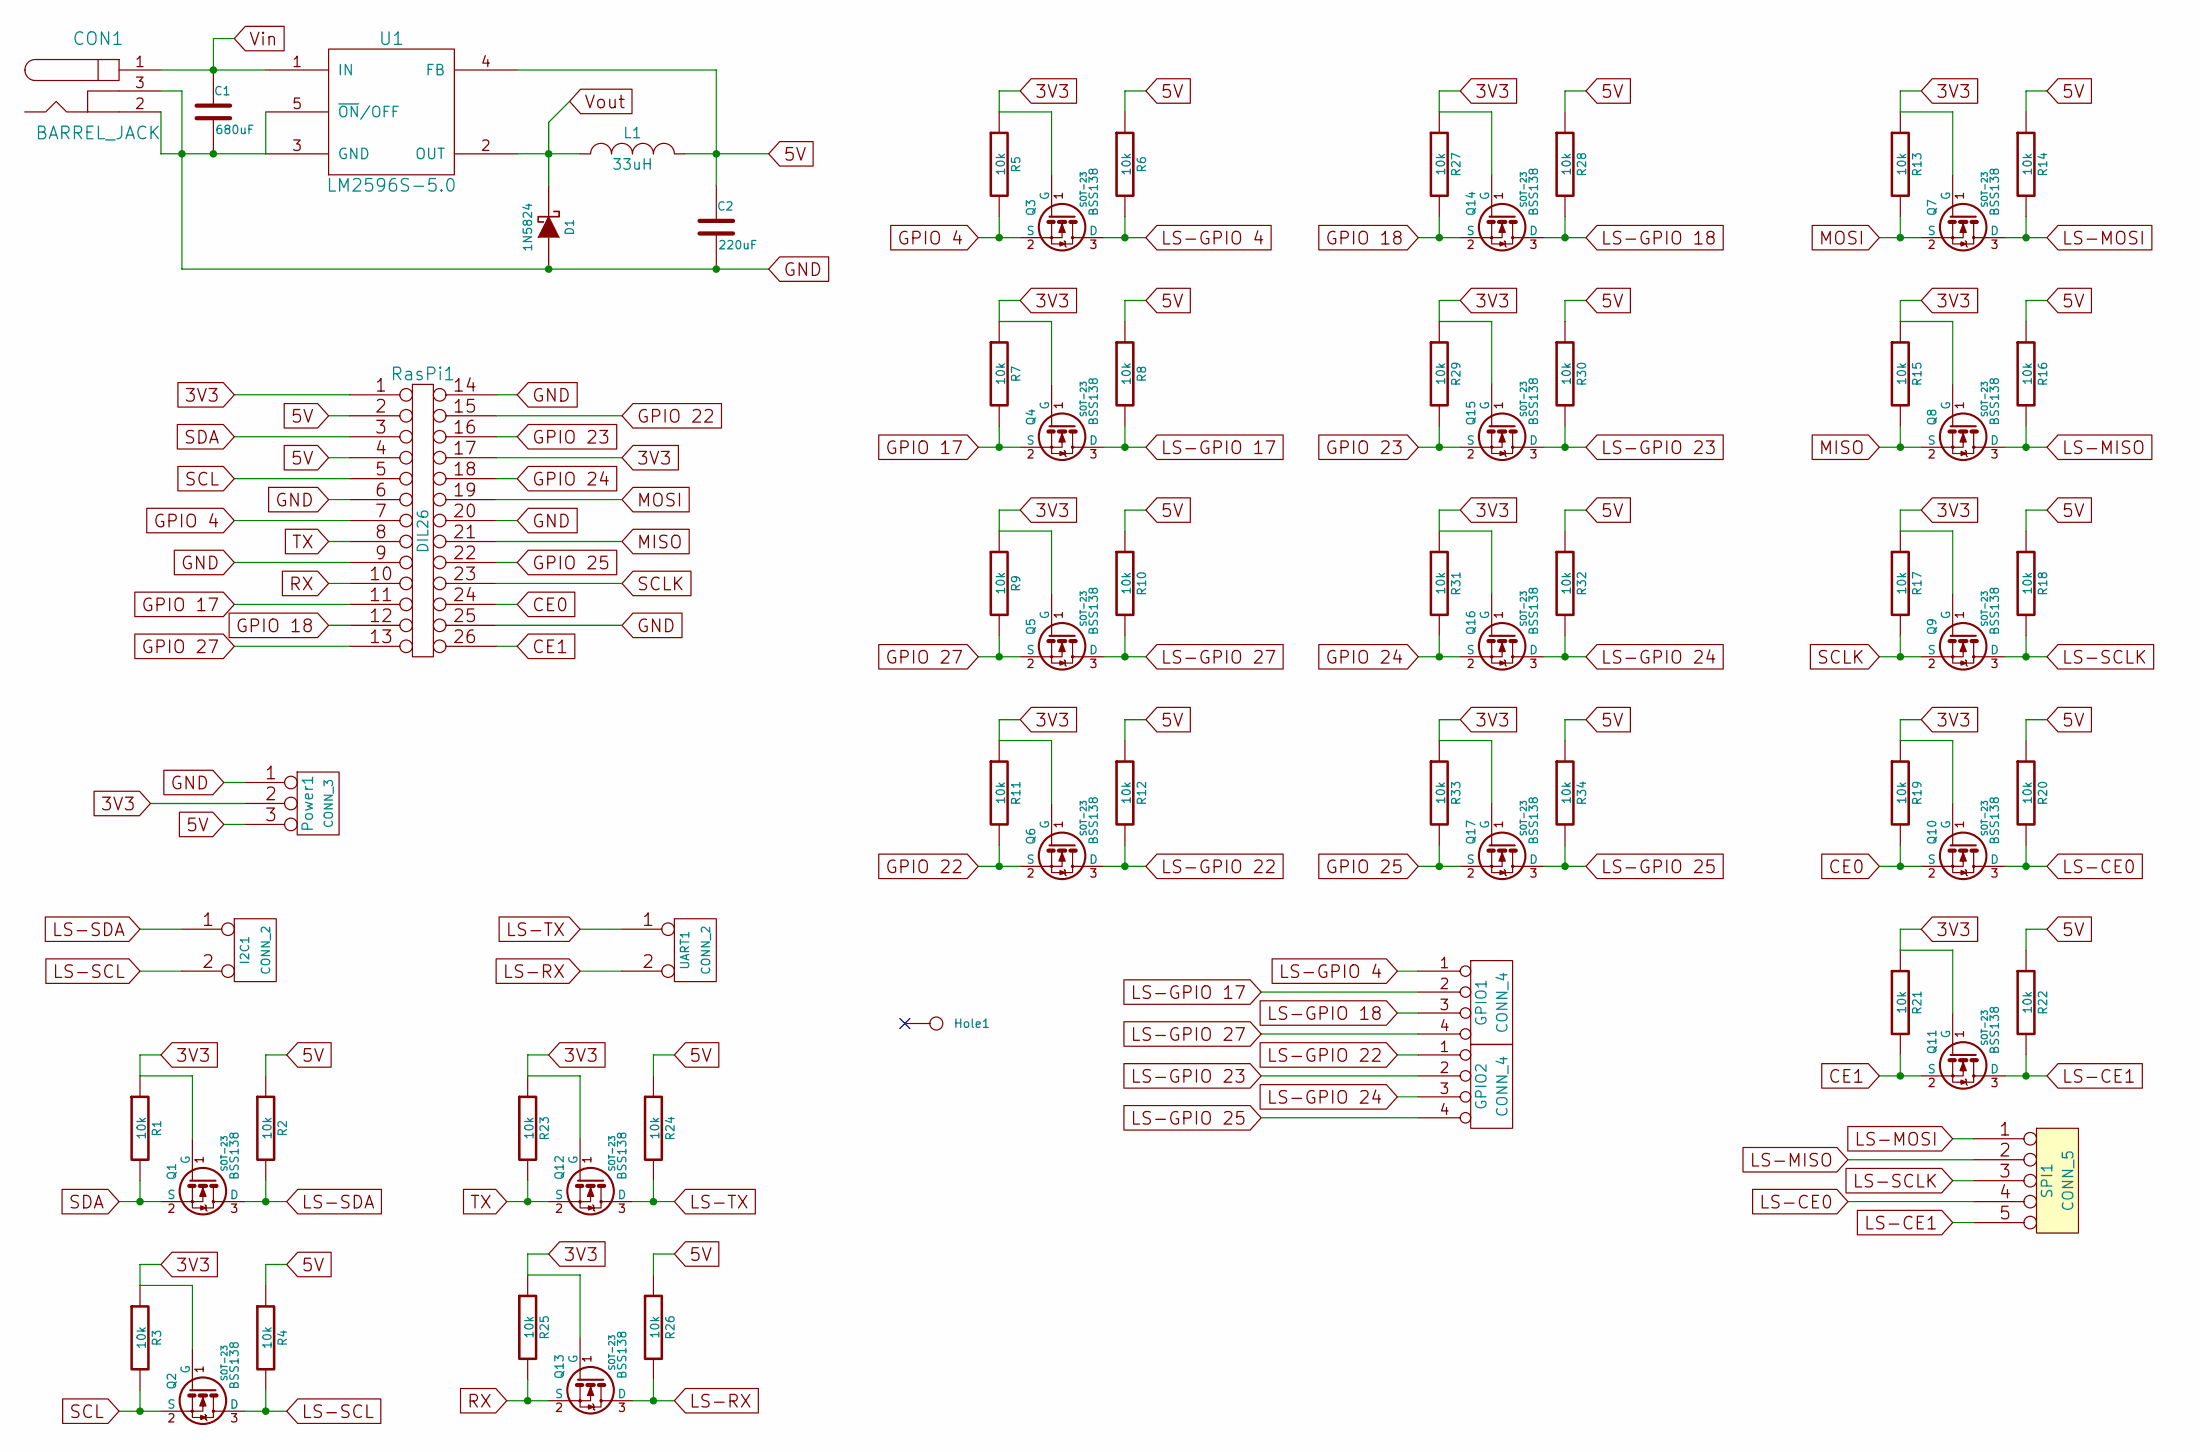
[picture p142: schematic securePi.sch]

Parts:
C1: 680uF
C2: 220uF
CON1: BARREL_JACK
D1: 1N5824
GPIO1, GPIO2: CONN_4
Hole1: CONN_1
I2C1: CONN_2
L1: 33uH
Power1: CONN_3
Q1, Q2, Q3, Q4, Q5, Q6, Q7, Q8, Q9, Q10, Q11, Q12, Q13, Q14, Q15, Q16, Q17: BSS138; SOT-23
R1, R2, R3, R4, R5, R6, R7, R8, R9, R10, R11, R12, R13, R14, R15, R16, R17, R18, R19, R20, R21, R22, R23, R24, R25, R26, R27, R28, R29, R30, R31, R32, R33, R34: 10k
RasPi1: DIL26
SPI1: CONN_5
U1: LM2596S-5.0
UART1: CONN_2

Connections:
3V3: Power1.2 (PM), Q1.1 (G), Q2.1 (G), Q3.1 (G), Q4.1 (G), Q5.1 (G), Q6.1 (G), Q7.1 (G), Q8.1 (G), Q9.1 (G), Q10.1 (G), Q11.1 (G), Q12.1 (G), Q13.1 (G), Q14.1 (G), Q15.1 (G), Q16.1 (G), Q17.1 (G), R1.1, R3.1, R5.1, R7.1, R9.1, R11.1, R13.1, R15.1, R17.1, R19.1, R21.1, R23.1, R25.1, R27.1, R29.1, R31.1, R33.1, RasPi1.1, RasPi1.17
5V: C2.1, L1.2, Power1.3, R2.1, R4.1, R6.1, R8.1, R10.1, R12.1, R14.1, R16.1, R18.1, R20.1, R22.1, R24.1, R26.1, R28.1, R30.1, R32.1, R34.1, RasPi1.2, RasPi1.4, U1.4 (FB)
CE0: Q10.2 (S), R19.2, RasPi1.24
CE1: Q11.2 (S), R21.2, RasPi1.26
GND: C1.2, C2.2, CON1.2, CON1.3, D1.1 (A), Power1.1, RasPi1.6, RasPi1.9, RasPi1.14, RasPi1.20, RasPi1.25, U1.3 (GND), U1.5 (~ON~/OFF)
GPIO 4: Q3.2 (S), R5.2, RasPi1.7
GPIO 17: Q4.2 (S), R7.2, RasPi1.11
GPIO 18: Q14.2 (S), R27.2, RasPi1.12
GPIO 22: Q6.2 (S), R11.2, RasPi1.15
GPIO 23: Q15.2 (S), R29.2, RasPi1.16
GPIO 24: Q16.2 (S), R31.2, RasPi1.18
GPIO 25: Q17.2 (S), R33.2, RasPi1.22
GPIO 27: Q5.2 (S), R9.2, RasPi1.13
LS-CE0: Q10.3 (D), R20.2, SPI1.4
LS-CE1: Q11.3 (D), R22.2, SPI1.5
LS-GPIO 4: GPIO1.1, Q3.3 (D), R6.2
LS-GPIO 17: GPIO1.2, Q4.3 (D), R8.2
LS-GPIO 18: GPIO1.3, Q14.3 (D), R28.2
LS-GPIO 22: GPIO2.1, Q6.3 (D), R12.2
LS-GPIO 23: GPIO2.2, Q15.3 (D), R30.2
LS-GPIO 24: GPIO2.3, Q16.3 (D), R32.2
LS-GPIO 25: GPIO2.4, Q17.3 (D), R34.2
LS-GPIO 27: GPIO1.4, Q5.3 (D), R10.2
LS-MISO: Q8.3 (D), R16.2, SPI1.2
LS-MOSI: Q7.3 (D), R14.2, SPI1.1
LS-RX: Q13.3 (D), R26.2, UART1.2 (PM)
LS-SCL: I2C1.2 (PM), Q2.3 (D), R4.2
LS-SCLK: Q9.3 (D), R18.2, SPI1.3
LS-SDA: I2C1.1, Q1.3 (D), R2.2
LS-TX: Q12.3 (D), R24.2, UART1.1
MISO: Q8.2 (S), R15.2, RasPi1.21
MOSI: Q7.2 (S), R13.2, RasPi1.19
RX: Q13.2 (S), R25.2, RasPi1.10
SCL: Q2.2 (S), R3.2, RasPi1.5
SCLK: Q9.2 (S), R17.2, RasPi1.23
SDA: Q1.2 (S), R1.2, RasPi1.3
TX: Q12.2 (S), R23.2, RasPi1.8
Vin: C1.1, CON1.1, U1.1 (IN)
Vout: D1.2 (K), L1.1, U1.2 (OUT)

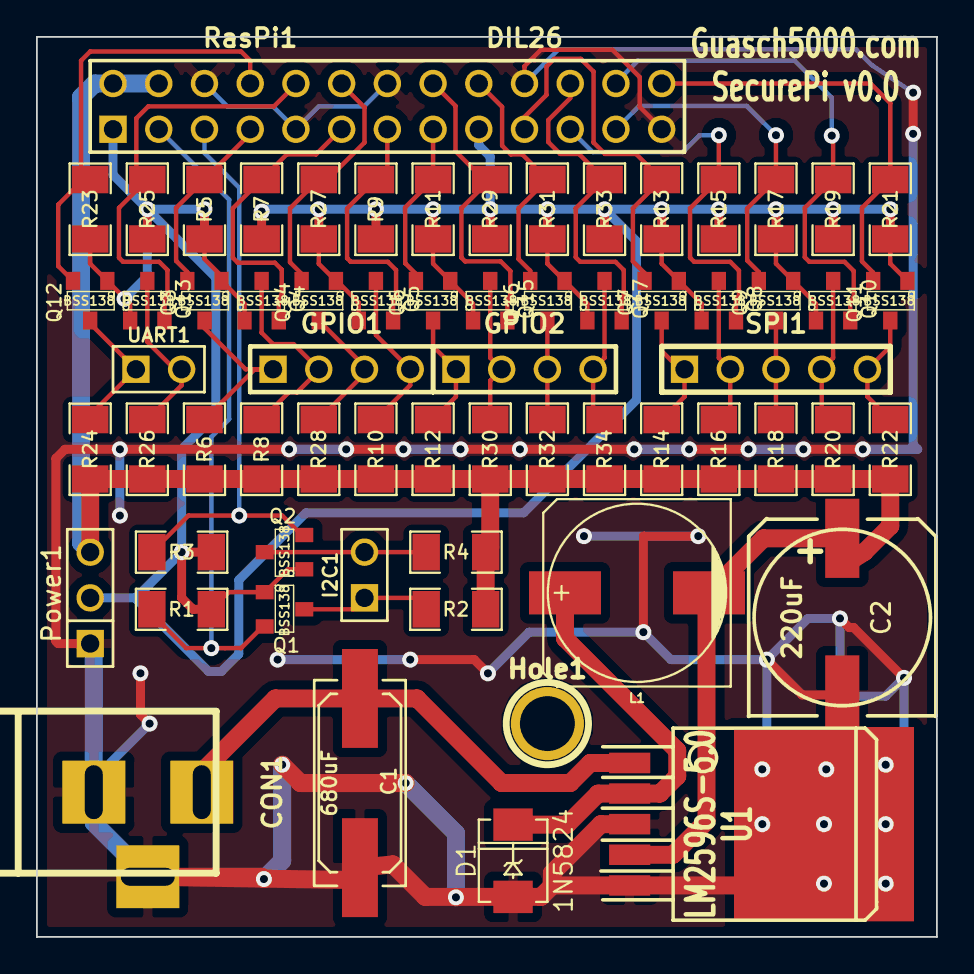
[picture p143: board securePi.kicad_pcb from above]

Board: 2 copper layers, 50.0 x 50.0 mm, 65 parts (0 on the bottom side), 39 nets.
