Guasch5000/RosPiBot/Kicad/PowerPi_Board/PowerMotorPi.kicad_pcb

## KiCad design Kicad/PowerPi_Board/PowerMotorPi.kicad_pcb (2014-03-10)

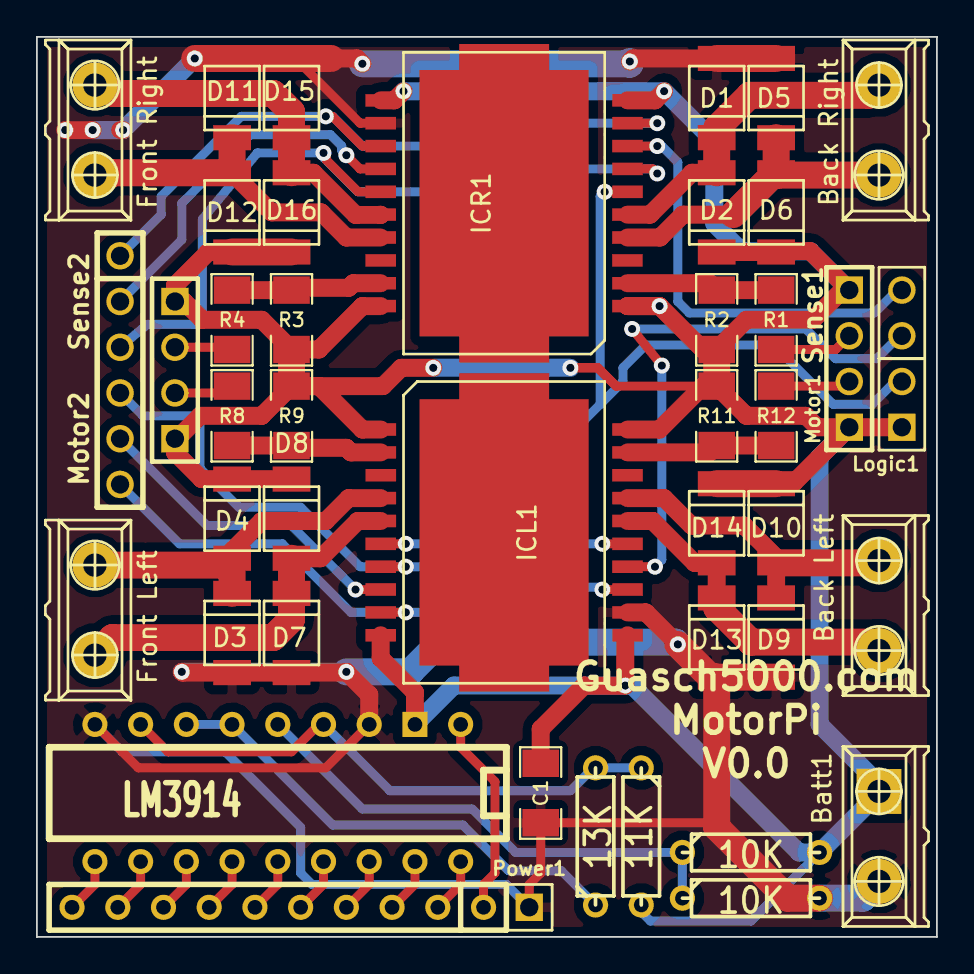
[picture p144: board PowerMotorPi.kicad_pcb from above]

Board: 2 copper layers, 50.0 x 50.0 mm, 44 parts (0 on the bottom side), 40 nets.

Parts:
Back Left: CONN_2; Block_Terminal_green_2_pins
Back Right: CONN_2; Block_Terminal_green_2_pins
Batt1: CONN_2; Block_Terminal_green_2_pins_Batt
C1: 1uF; SM1206
D1, D2, D3, D4, D5, D6, D7, D8, D9, D10, D11, D12, D13, D14, D15, D16: DIODESCH; SMD_Schottky
DIP1: LM3914; DIP-18__300
Front Left: CONN_2; Block_Terminal_green_2_pins
Front Right: CONN_2; Block_Terminal_green_2_pins
ICL1: L298; L298P
ICR1: L298; L298P
LED1: CONN_10; SIL-10
Logic1: CONN_2; PIN_ARRAY_2X1
Motor1: CONN_2; PIN_ARRAY_2X1
Motor2: CONN_6; PIN_ARRAY-6X1
Power1: CONN_1; PIN_ARRAY_1
R1, R4, R8, R12: 1K; SM1206
R2, R3, R9, R11: 0.5; SM1206
R5, R6: 10K; R3
R7: 11K; R3
R10: 13K; R3
Sense1, Sense2: CONN_4; PIN_ARRAY_4x1

Connections:
5V: ICL1.6, ICR1.6, Logic1.2
GND: Batt1.1, C1.1, D2.1, D4.1, D6.1, D8.1, D10.1, D12.1, D14.1, D16.1, DIP1.2, ICL1.1, ICL1.10, ICL1.11, ICL1.20, ICR1.1, ICR1.10, ICR1.11, ICR1.20, Logic1.1, R2.2, R3.2, R6.2, R7.2, R9.2, R11.2, Sense1.1, Sense1.4, Sense2.1, Sense2.4
IN: DIP1.5, R5.1, R6.1
L Enable A: ICL1.8, Motor2.5
L Enable B: ICL1.14, Motor1.2
L Input 1: ICL1.7, ICL1.15, Motor2.4
L Input 2: ICL1.9, ICL1.13, Motor2.6
L Out 1: D3.1, D4.2, Front Left.2, ICL1.4
L Out 2: D7.1, D8.2, Front Left.1, ICL1.5
L Out 3: Back Left.2, D13.1, D14.2, ICL1.16
L Out 4: Back Left.1, D9.1, D10.2, ICL1.17
L Sense A: ICL1.2, R8.2, R9.1
L Sense ADC A: R8.1, Sense2.2
L Sense ADC B: R12.1, Sense1.3
L Sense B: ICL1.19, R11.1, R12.2
Led 1: DIP1.1, LED1.1
Led 2: DIP1.18, LED1.2
Led 3: DIP1.17, LED1.3
Led 4: DIP1.16, LED1.4
Led 5: DIP1.15, LED1.5
Led 6: DIP1.14, LED1.6
Led 7: DIP1.13, LED1.7
Led 8: DIP1.12, LED1.8
Led 9: DIP1.11, LED1.9
Led 10: DIP1.10, LED1.10
R Enable A: ICR1.8, Motor1.1
R Enable B: ICR1.14, Motor2.2
R Input 1: ICR1.7, ICR1.15, Motor2.3
R Input 2: ICR1.9, ICR1.13, Motor2.1
R Out 1: Back Right.2, D5.1, D6.2, ICR1.4
R Out 2: Back Right.1, D1.1, D2.2, ICR1.5
R Out 3: D15.1, D16.2, Front Right.2, ICR1.16
R Out 4: D11.1, D12.2, Front Right.1, ICR1.17
R Sense A: ICR1.2, R1.2, R2.1
R Sense ADC A: R1.1, Sense1.2
R Sense ADC B: R4.1, Sense2.3
R Sense B: ICR1.19, R3.1, R4.2
R_hi: DIP1.6, DIP1.7, R10.1
R_lo: DIP1.4, DIP1.8, R7.1, R10.2
VSS: Batt1.2, C1.2, D1.2, D3.2, D5.2, D7.2, D9.2, D11.2, D13.2, D15.2, DIP1.3, DIP1.9, ICL1.12, ICR1.12, Power1.1, R5.2
