Guasch5000/RosPiBot/(commit log)

2014-03-10 including all kicad files
    [PowerMotorPi-B_Cu.gbl, PowerMotorPi-B_Mask.gbs, PowerMotorPi-B_SilkS.gbo, PowerMotorPi-Edge_Cuts.gbr, PowerMotorPi-F_Cu.gtl, PowerMotorPi-F_Mask.gts, PowerMotorPi-F_SilkS.gto, PowerMotorPi.drl]
2014-03-17 adding I2C ultrasound sensor comunication
2014-03-18 adding reading with two devices
2014-03-27 Adding battery modifications
2014-04-01 Updating Raspberry Pi description
2014-04-01 Quadrature Encoder explanation (after coffee)
2014-04-02 Updating battery decision
2014-04-08 Adding ADC module comunication via I2c
2014-05-07 adding regulator descripction
2014-05-07 More Buck description
2014-05-13 PCB definitions
2014-05-17 Ading Wired connections Latex
2014-05-18 Finished assembly chapter
2014-05-18 Adding SolidWorks files
    [Barra transversal.SLDPRT, Bateria 7.4V 6000mAh.SLDPRT, Coupling.SLDPRT, Ensamblaje escuadra.SLDASM, Ensamblaje escuadra.SLDDRW, Etehrnet panel mount.SLDPRT, Ethernet panel mount.SLDPRT, GY-80.SLDPRT]
2014-05-26 Adding planification and gantt diagram
    [presupuesto.xlsx]
2014-06-04 Latex Template
    [PowerMotorPi-B_Cu.gbl, PowerMotorPi-B_Mask.gbs, PowerMotorPi-B_SilkS.gbo, PowerMotorPi-Edge_Cuts.gbr, PowerMotorPi-F_Cu.gtl, PowerMotorPi-F_Mask.gts, PowerMotorPi-F_SilkS.gto, PowerMotorPi.drl]
2014-06-04 Revert to 56e05fced
    [PowerMotorPi-B_Cu.gbl, PowerMotorPi-B_Mask.gbs, PowerMotorPi-B_SilkS.gbo, PowerMotorPi-Edge_Cuts.gbr, PowerMotorPi-F_Cu.gtl, PowerMotorPi-F_Mask.gts, PowerMotorPi-F_SilkS.gto, PowerMotorPi.drl]
